aboufama/exo-shoulder/REQUIREMENTS.md

# Requirements

Every requirement is a number with a pass/fail threshold and **one judge that is not the design pipeline and not the agent's
opinion**. `judge/requirements.json` is the machine-readable copy; `judge/scorecard.py` evaluates a design against it.

The user's original statement of the goal, which outranks everything below:

> The whole mechanism must ride less than ~1 cm from the skin across the whole shoulder, over the full range of motion
> (overhead matters most). At most 4 degrees of freedom: 3 joints + a sliding cuff, or 4 joints and no cuff. Everything
> else (mechanism family, joint placement, link shapes, materials, attachment points) is free.

Added by the user on 2026-10-14 (their words):

> "Honestly it would be amazing if it can be handled in only 3 degrees of freedom (less actuators)" ... "3 dof is
> theoretically possible, it just takes a lot of engineering" ... "you could even put upper arm rotation in its own DOF
> farther down from the shoulder and just have to handle 2 at the shoulder joint! If they could fully overlap each
> other, you'd get rid of a lot of collision issues, also you can make it within 14mm if you really need to"

So: **3 DOF is the target** (the cap stays 4); **10 mm stays the target band**, 14 mm is allowed where it is really
needed (e.g. nested links) and is always reported separately (score_design.py `BAND_HI=14`).

And later the same day (their words): "Yes you can download, I mean kinematicly 3dof so nothing is powered we view all
joints as the same. Unless you can find a way to leave one joint unpowered and not require torque to it to use full ROM
that is an exception if you know what I'm saying you can make it as thin as possible, we're using titanium after all".
So: **DOF are counted kinematically - every joint counts, powered or not.** **One exception**: a joint that is left
unpowered and needs no torque (no effort from the wearer) over the full ROM, e.g. a gravity-balanced, self-aligning
passive slider that only lets the rotation centre follow the girdle. **Links as thin as titanium allows** (thickness is
a design variable sized by FEA, not a fixed 5.5 mm). The user approved downloading OpenSim and the Seth 2016 model and
accepted its CC BY-NC-SA 3.0 licence (the experimental bone-pin data in that archive is restricted to verifying the
Seth model and was not used).

**User decisions, 2026-10-15.** Base: "It should ride the scapula, as the next kinematic element is the scapula
handler" - the scapula handler is "a separate part I already designed, you only have to worry about the exactly 3
degrees of freedom found in the shoulder, the minimum possible solution is 3 dof, which is why I'm pushing so hard for
it". Joint count: "I would REALLY like 3 joints, but just push for as low a joint count as possible, this is a huge
reward". Proximity: pass at 14 mm, aim for 10 mm (both reported).

**User decisions, 2026-10-15 (after the sim-to-real register, docs/research/sim_to_real_gaps.md).** Actuation:
remote motors with cables to the joints. Assist: "Don't worry about this at all since they're offset but it would be
very subtle just a bit more than gravity" -> design load = gravity support of the arm plus a margin (~10 N.m peak at
90 deg elevation for an average arm; R9's 25 N.m is retired as the design case). GH-centre error: torque-free passive
self-aligning slides at the cuff, outside the 3-DOF count. Bearings: "use actual tiny needle bearings if possible try
to optimize assuming very high quality bearings" -> rolling (needle / thin-section) bearings at every joint; the
plain-bearing self-locking risk (G6) is designed out, the joint keep-out becomes bearing + cable pulley.

| ID | Requirement | Threshold | Judge | Why this threshold |
|---|---|---|---|---|
| R1 | Proximity: share of the covered skin that is 2-14 mm from the metal, while following | >= 90 % (aim: the same at 2-10 mm, reported as R1-aim) | `pipeline/full-exo/score_design.py` with BAND_HI=14 (exact posed skin, 30 fps) | the 1 cm rule with the user's allowance: pass at 14 mm, aim for 10 (2026-10-15); 2 mm keeps the liner/clearance |
| R2 | No part enters the body, any frame of any clip | <= 0.5 mm | `judge/body_contact.py` (exact signed distance to the posed, closed body mesh) | 0.5 mm = tessellation tolerance; anything more is visible pass-through |
| R3 | The exo follows the arm (frames tracked rather than held at a joint limit) | >= 95 % of frames | `score_design.py` | a held frame means the user's arm is blocked |
| R4 | Overhead works: "Raise overhead" clip score (14 mm band) | >= 80 % | `score_design.py` BAND_HI=14 | the user called earlier designs "unusable" overhead |
| R5 | Degrees of freedom of the shoulder chain (scapula base to arm), counted kinematically (every joint, powered or not) | <= 4; **aim exactly 3** (R5-aim) | `design.json` | user cap and counting rule (2026-10-14); the user's scapula handler is a separate part outside the count, and 3 is the minimum and the goal (2026-10-15) |
| R6 | No interference between parts that move relative to each other | <= 0.15 mm | `judge/part_contact.py` (geometry only) | designed coaxial fits (pin in sleeve, washer on seat) sit inside 0.15 mm |
| R7 | Every custom part is one valid, closed solid | all | `judge/part_validity.py` (OCC BRepCheck on the exported STEP) | a supplier must be able to read and machine it |
| R8 | Custom-part mass | <= 300 g (proposed) | `parts_full.json` (mesh volume x density) | placeholder budget, **confirm with the user** |
| R9 | Strength SF >= 1.5 at the design load (arm gravity support + margin, ~10 N.m; was 25 N.m), worst direction; deflection keeps the 2 mm floor; fatigue bounded | - | **independent FEA (CalculiX)** - today only the in-house hex8 study (`pipeline/conformal/thin_study/REPORT.md`) | 25 N.m = assist torque design load |
| R10 | The base rides the scapula on the user's scapula handler: worst-frame GH-centre misalignment from the base slipping over the bone | <= 4 mm (proposed) | `judge/base_mount.py` (girdle mount: skin-slip model still to build -> NOT RUN; designs with a thorax base keep the three-girdle-law check: rig, published bone-pin chain, **OpenSim Seth 2016**) | 4 mm = half the 2-10 mm band: a misalignment shifts the metal against the skin by up to that much (docs/P0_BASE_MOUNT.md) |
| R11 | Interface pressure under the ISO/TS 15066 body-region limits | - | coupled human-exo contact simulation, then pressure film / FSRs on a prototype | comfort and safety at the cuffs |
| R12 | CAD standard: G2 surfaces, flat seats under every seat, no visible screws or seams | - | zebra / curvature check (`pipeline/full-exo/parts.html`) + user review | the user's own parts set the bar (docs/CAD_STANDARD.md) |
| R13 | Manufacturable | - | supplier DFM review and quote (CNC Ti-6Al-4V / 7075, SLM AlSi10Mg) | only a supplier can say yes |
| R14 | Generalises to motions and bodies never used to design it | - | held-out OpenCap / AMASS clips and SMPL-X bodies (`data/raw/`) | the 8 design clips are synthetic and were optimised against |
| R15 | Works on real bodies | - | printed prototype on the user + one very different body: OpenCap reach vs bare arm, zero contact on skin FSR strips | the final judge |

R1-R8 and R10 are measured today. R9-R15 are the work that turns this from a simulation result into an engineering result.
