aboufama/exo-shoulder/docs/FINDINGS.md

# Findings so far (2026-10-09 .. 2026-10-14)

What has been learned, with numbers, so nobody re-derives it. Earlier history and commits:
github.com/aboufama/exo-arm (archive, private).

## Score history (honest score = `pipeline/full-exo/score_design.py`: follow x share of covered skin 2-10 mm)

| design | honest | notes |
|---|---|---|
| conformal 4R, first CAD (`designs/final`) | 8.1 % | 15-20 mm median gap, overhead follow 39 % |
| band designs, simplified geometry (`designs/band_4c_best`) | 80.5 % | **5 DOF** (4R + cuff), 4.0 mm links, no real stacks / neck / rail - not buildable as modelled |
| GPU search on real geometry, r13 (`gpu_client/band_search_r13.json`) | 37-45 % search, 35-37 % local detail | 5.5 mm links (FEA), v4 joint stack, hugging neck, back/top base |
| r13 4R built as fair CAD, first build | 38.0 % | follows 64.5 %, in-band 58.9 %, zero collisions |
| same, after the quality pass (swept-band links, turned JN hub, conformal saddle cuff) | 29.6 % | follows 64.5 %, in-band 45.9 %; the turned JN hub had lost its contoured skin side |
| same, turned skin side restored (dimple) + neck fixes (2026-10-15) | 32.0 % | follows 64.5 %, in-band 49.6 %, overhead 20.7 %. Same rebuild with the old flat hub: 30.2 % -> the skin side is worth +1.8 pts, the neck changes +0.6 |
| r13 3R + sliding cuff (`cad_r13_n3_s1331_0`), first build with every part valid | 21.2 % | follows 61.0 %, in-band 34.8 %, overhead 20.5 %, 436 g (R8 fail: Ti rail + keel); see "Arm end" |

**Measurement changes are not design regressions.** Stricter skin, natural motions and the in-band metric each moved
numbers on 2026-10-13. Always report a score change with its cause.

The search evaluator (`pipeline/conformal/gpu/band_impl.py`) is optimistic against real CAD: 4 mm slabs, sparse
samples, no stacks/neck early on. The honest scorer on built CAD is the reference.

## The base mount -> R10 (measured 2026-10-14, docs/P0_BASE_MOUNT.md)

The pipeline held the base fixed in the **scapula** frame; physically it bolts to a back plate on the **thorax**. On the
rig's girdle law (GH lift 0.2 mm/deg above 30 deg, scapula rotating about GH), all 1337 frames:
- GH rises up to **25.3 mm** vs the thorax (4 mm at 49 deg elevation, 10 mm at 77 deg); the scapula turns up to 58 deg.
- The reference base on a thorax plate: **enters the body in 197 of 446 frames, up to 44 mm** (Raise overhead) - every
  design so far was shaped against skin that moved with its base.
- **Bound**: any chain whose axes meet at one thorax-fixed point misaligns the GH centre by >= half the GH range =
  **12.7 mm** > the 8 mm band. The fixed-centre family on a back plate cannot meet the 1 cm rule overhead.
- **Offset axes absorb it without a joint**: for fixed axis directions, the GH point a serial chain carries is linear in
  the axis points (`pipeline/girdle/girdle.py`), so the best points are an exact minimax LP. 3-DOF on a thorax plate:
  3R **5.8 mm**, 2R shoulder + humeral-rotation ring **6.8 mm** (vs 25.3). Not yet <= 4 mm (R10 proposed). Sensitive to
  the girdle law: +25 % slope -> 10.8 / 12.5 mm. The residual is flat in elevation: no chain reproduces the rig's
  0-then-linear kink.
- 3R's singular margin: 20 deg on fitting clips, **12.5 deg on held-out** clips. The 2R pointing shoulder: the arm never
  comes within **45 deg** of one axis over the 8 clips -> its singularity has a home (55 deg margin held-out).
- **Humeral-rotation ring**: travel can be 67 deg (87 with held-out Wave; floor 59 deg = twist the clips use at the same
  arm direction). A circular rail on link 2 sees **13.5-25 mm of skin-radius spread** over 120 deg at every station
  80-280 mm down the arm (only the deltoid cap, ~60 mm, is round: 4.7 mm) -> the rail must be arm-fixed and shaped.
- Judge: `judge/base_mount.py` (R10 on every scorecard). Still the rig's law: OpenSim Seth 2016 / OpenCap must replace it.

## Published girdle motion and the red team (2026-10-14)

- **The rig's girdle law is 2-3x too small and 1-D** (docs/research/gh_translation_literature.md): bone-pin clavicle /
  scapula angles through a rigid clavicle chain put GH +35 mm superior at 90 deg scaption (rig 12.7), plus 5-24 mm
  posterior and 10-28 mm medial, plane-dependent; vector error of the rig 16-51 mm. +-7-12 mm (1 SD) is not a function
  of arm orientation. The rig's scapular rotation rates match bone pins, but it pivots the scapula about GH instead of
  the AC joint. Acromion skin plates track the scapula to 5-7 deg below 100-120 deg elevation, up to 25 deg above.
- Under that law (`girdle.lift_literature`): reference chain on a thorax plate 64.9 mm; offset-axis 3-DOF refits
  10.7-19 mm on fitting clips, 22-26 mm held out (`p0_literature.json`).
- **Red team** (pipeline/redteam/REPORT.md): orientation-only chains are >= 12.5 mm off for a -10..+15 mm shrug; the
  reference 4R cannot close in 19 % of the plausible workspace (47-49 % of cross-body poses); P0's 3R gimbal-locks at an
  arm-forward pose near walking (a1 ~ a2); the least-travel ring has a 21 deg closure hole at the T-pose; the elevation
  assist never lands on the rigid saddle - the knit band carries all of it (25 N.m on the saddle = 18 kPa mean).
- **Kinematic optima are not designs**: P0's 3R built as L1 keep-out CAD (`designs/l1_3r_offset`) scores R1 0.1 %,
  R2 25 mm, R6 51 mm - its thorax-fixed J1 hub sits where the raised arm goes. (Fixed contact judges, 2026-10-15: R2
  24.9 mm holds, R6 2.4 mm - the 51 mm was a sign error.)
- **Rig vs the user's parts**: the user's forearm cuff (24 mm) and BOTTOM sit inside the rig's arm in every frame - the
  rig's forearm / elbow is likely too big (P2 scans).

## The human model is wrong in measurable places -> P2

- **Biceps bulge**: the swept upper-arm envelope (max over all frames) sits up to 25-30 mm above the relaxed skin at the
  anterior midline (theta ~ -90 deg about the humerus, s 160-190 mm from GH) at full flexion (132 deg). Triceps ~10 mm.
- **No contact model**: in "wash opposite shoulder" the upper arm passes into the chest; in "walking" (axial -90, arm
  at the side) the posterior-medial arm passes into the torso. Anything hugging the arm inherits these overlaps.
- The upper arm is not round about the humerus: skin radius 36-70 mm depending on direction.

## Cuffs

- **The old upper cuff** (user's forearm cuff scaled x1.24) entered the body in 7 of 8 clips, up to 46 mm, including
  the lateral side. (An earlier check missed it: a name-matching bug skipped it.)
- **A rigid C-cuff wing cannot exist** beyond theta = -20 .. +62 deg about the humerus (0 = lateral, + posterior)
  without touching the trunk or chest in some ADL frame (`fair_cad/out_cuff/trunkmap.npz` method,
  `fair_cad/cuff_trunkmap.py`). Current cuff = a lateral **saddle** under BOTTOM (`fair_cad/cuff_fair.py`): fair
  shrink-wrap inner surface over the swept envelope + 2 mm compressed liner, flat land in BOTTOM's plane, 5 lines + 5
  tangent arcs outline, 6x M4x6 ISO 10642 from inside (same thread engagement as the user's M4x8), 40.6 g AlSi10Mg.
  Zero body contact in every frame. The knit band wraps the rest of the arm.
- The user's **forearm cuff** (not ours, not modified) enters the forearm/biceps 19-27 mm at deep flexion and the torso
  in walking. Flag to the user; do not change their part.

## Links and joints

- **Short link** (r13 4R): J1-J2 hub centres 24.7 mm apart (1.7 mm between the O23 seats), axes 24 deg apart, 5 mm
  height step. No surface treatment fixes it - the search needs a minimum arc (~35 deg at R ~60 mm) so every link has a
  real arm. Same failure the user called "heinous" earlier (two hubs side by side).
  **Guarded since band code `band-2026-10-15t`**: job keys `min_arc` (35 deg; bounds the samplers, rejects in evaluate)
  and `min_arm_mm` (10 mm clear between a link's two hub seats at the fitted hub heights, after the shape fit);
  `make_cad_design.py` refuses either (override `--allow-short-link`, only with the user's OK). The deg rule alone is not
  enough: 35 deg leaves 16.1 / 13.1 / 10.1 / 7.1 / 4.1 mm between O23 seats (r 11.5) with hubs 65 / 60 / 55 / 50 / 45 mm
  from GH, and 5.1 mm at 65 mm with r 17 seats. Conversely r13's link 3 (29.6 deg) has 16.9 mm at its fitted 74 / 80 mm
  hub heights: the deg rule rejects it, the mm rule would not. The evaluator's geometry puts r13's link 1 at 2.1 mm.
- **Construction that reads as designed** (members.py `FIELD_MODE=swept`, default): each arm a swept constant-section
  band (straight generators across its 14 mm width, one fair height profile along it, clamped in value and slope to the
  hub planes), thickness easing hub stack -> 5.5 mm over 12 mm, G2 blend into exact hub planes over 4 mm. The earlier
  2-D "fair field" and the original local-lift fields produced folds and lumps.
- **Stacked joints**: the lower link's top must stay under its seat plane + 35 deg near the hub (it thickens toward the
  skin instead), otherwise the upper link leaps over it in a cliff. Joints whose hub plane sits below the skin floor get
  raised (ramp check) - J1 needed 3.7 mm once; cap lower hub plates at 6.5 mm or they become blocks.
- **Edge round 0.5 mm on links**: with 1.2 mm the flat seat ended at r 10.3 and the O22 cap skirt (r 9.3-11) and its
  M1.6 screws (r 10.15) overhung the round - a fit error and an invalid sliver face.
- **v4 joint** (`fair_cad/joint_v4.py`, docs/HARDWARE.md): O23 hub, 10.47 mm above the skin face; magnet + sensor PCB
  placeholders under a O22 G2 dome cap.

## Arm end (BOTTOM + neck + J4 hub, one 7075 part)

- **Turned hub + swept neck** (`armend_fair.build_hub_neck_v2`): revolve with exact seat; neck = constant 14 x 6.5
  section along the skin-hugging path, starting 6 mm inside the hub.
- **Turned skin side** (`hub_need` / `fit_underside`): per ring radius the axial height the dense envelope allows (max
  over the ring and all followed frames, skin + 2 mm + 0.5), then the closest sketch above it - centre flat + cone
  (+ the old face F as an outer annulus = "dimple"), short G2 corner blends, revolved. r13 n4: centre 3.1 mm under F to
  r 2.5, 25 deg cone back to F by r ~10. Radial skin gap under the hub: min 3.15 -> 2.71 mm, worst-frame median 7.14 ->
  4.78, all-frames median 13.33 -> 11.46; exact body clearance of the hub region (451 frames) 2.68 -> 2.60 mm.
- **Neck end**: morphing the 14 mm neck into BOTTOM's 30 mm bar section over the last few mm folded the loft (the
  lateral face self-intersects; OCC `isValid` still says True, every later boolean silently fails). Now the neck keeps
  14 x 5.5 and runs 6 mm into BOTTOM past the cut -> plain transversal fuse (`NECK_END=bar` = old). Inside the hub it
  starts 5.9 thick (0.3 inside both hub faces) so nothing is coincident or tangent; a flat face 0-0.4 mm under F is
  snapped to F (a neck underside grazing the rim blend broke the recess cut). Check lofts with
  `armend_fair.self_x` (BOPAlgo_ArgumentAnalyzer), not `isValid`.
- **3R + sliding cuff** (`cad_r13_n3_s1331_0`): every part one valid solid now (R7). What was broken:
  (1) `sheet.sheet_solid` sewed the 5 faces at 5 um and took the FIRST shell: on steep members the edge rounds drift
  from the exact trimmed outline, sewing leaves several shells -> an open 3-4 face "solid" with a meaningless volume
  (reproduced on the official maps: link 1, 4 faces, invalid). Now: retry 0.02-0.1 mm, keep the one closed shell.
  (2) the evaluator's ribbon floor for link 2 started 29 mm above J2's plane at J2's rim (JN plane 119 mm vs J2 61 mm
  from GH, ramp-limited from JN only) -> an 85 deg wall, J2 raised 12 mm by the ramp loop, link 2's skin side 8 mm inside
  the envelope. Now the floor is capped at RAMP_DEG out of every hub plane (`Member.ramp_cap`): J2 raise 2.6 mm, link 2
  -1.4 mm, link 1's J2 hub 0.8 mm over its need (was 9.2). (3) rail + neck were ONE loft whose dovetail-with-keel
  sections morphed into the neck: self-intersecting -> the BOTTOM merge returned 0 cm3 and assemble crashed. Now
  (`build_dovetail_rail_neck`): exact revolve head, straight-quad keel loft to the skin envelope, separate neck (smoothing
  spline path, approach run down the bar's axis). (4) saddle: channel tool had a sign error (a 13 mm rectangular slot,
  no dovetail) and the 18 mm plate was narrower than the v4 washer recess (r 9.15-9.3) -> recess broke out of its
  sides; now the dovetail + liner offset, plate 2 x 12.3. (5) the top-mounted base: cap-screw drills ended exactly on the
  seat face (invalid solid) and the 3 M2 back-plate holes sat 0.075 mm from a cap-screw hole / 0.55 mm from the disc
  edge; now drills cross the face, M2 at r 12 between the cap screws on a O28 disc.
- Still wrong on the 3R build: the neck runs back beside the rail toward the bar and grazes the saddle's lip in the
  last ~2.5 deg of travel (0.44 mm at the clips' max 45.0 deg, 0.55 at the 45.6 deg limit; true ray-parity check); the
  rail part enters the body by 1.0 mm (ray-parity verified, 'Wave' 60); the JN plate sits ~35 mm above the skin
  (zj4 112) so the skin-following keel is 4.5-40 mm deep and the rail part is 63 cm3 of Ti (R8 436 g).
- **Travel of an arc slide / open ring** (for a 2R + humeral-rotation ring): an ARM-fixed ring at this rail's height (64 mm
  down the humerus) is body-free (> 2 mm, all 451 clip frames, exact distance) only over 130 deg at r 92 mm about the
  humerus axis and 124 deg at r 80; at r 70 (about skin + 1 cm) it hits the body even at its centre. Travel + the
  saddle's length (+-8 deg) + the neck must fit inside that window, so 120-160 deg of travel cannot be an arm-fixed rail
  here; the long arc has to ride on the shoulder side (it then does not turn with the humerus) with a short arm-fixed
  cuff, and its constant radius stands off a non-round arm (36-70 mm skin radius). Other limits seen in this build:
  one-end neck = a long cantilever arc; the 26 mm saddle and the stop slot set the end stops; the neck must leave
  beyond the saddle's reach (here the body window ends 0.3 deg past the saddle's travel).

## Structure (in-house FEA, `pipeline/conformal/thin_study/REPORT.md`)

25 N.m worst direction: link bodies need ~5.5 mm (SF 1.5); seat zones carry 0.3-0.6x body stress; a cuff rail needs
>= 10 mm in Ti; the 7075 neck at 14 x 6.5 has SF ~2. **Not independently verified (R9).**

## Infrastructure

- RunPod Flash endpoints: band evaluator `exo-band10` (5ogdx1ex9wyh02), Blender Cycles render `exo-blender-cycles`
  (dj3qfmtwrwy2pr). Warm workers serve old code after a deploy -> new endpoint name per code change, check
  CODE_VERSION. Queued jobs may need `workersMin` PATCHed > 0 to start; reset to 0 after. Account quota 10 workers.
- The dense per-frame skin maps (`.cache/maps_s1.pt`, 857 MB) are not in git: `tools/build_maps.py`.
- **The contact judges over-reported - fixed 2026-10-15 (judge/sdist.py, judge/test_sdist.py).** The old sign came from
  the face normal of the nearest of 10 triangle centroids; on long glb facets and the coarse body mesh (median edge
  8 mm, max 87 mm) the true closest triangle was often not among them (e.g. "link 2 IN J2 cap" 4.78 mm where ray parity
  in 3 directions and the winding number find 0 points inside), and the posed body self-intersects (winding up to 3)
  where no normal-based sign exists. Now: exact closest point (covering samples + one ball query) and the integer
  winding number (scanline grid + segment crossings). Test vs brute force: wrong inside 0 % on cube, sphere, a real
  part and the posed body (old: 0 / 0 / 2.6 / 2.8 %), |d| error 0. **Measurement change** on the reference
  (cad_r13_n4_s1343_1): R6 37.64 -> 0.80 mm (15 pairs > 0.15 mm), R2 24.43 -> 24.62 mm (the user's forearm cuff vs the
  rig's forearm: a size mismatch, not exo metal).
  Follow-up the same day: vertices are welded first (glb = one tessellation per B-rep face; the pseudo-normal sign of
  `signed_distance` needs shared edges). Every part closes after welding except the 3R BOTTOM + rail (11 boundary + 4
  non-manifold edges), which the first winding version skipped as a container (38 pairs, including the cuff's liners
  on the rail). It is now tested by the majority of x / y / z ray sweeps, with the generalized winding number wherever
  they disagree; test_sdist adds a raw (unwelded) part, a sphere with 4 holes and the open BOTTOM: 0 % wrong.

  | measurement change (no design changed: score.json, part_validity.json re-ran identical) | R2 before -> after | R6 before -> after |
  |---|---|---|
  | `cad_r13_n4_s1343_1` (4R), `judge_all.sh fast` (R2 step 6, R6 step 12) | 24.43 -> **24.62 mm** | 37.64 -> **0.80 mm** |
  | same, full run (R2 step 2, R6 step 4; the committed outputs) | 24.62 mm | 0.80 mm |
  | `cad_r13_n3_s1331_0` (3R + sliding cuff), `judge_all.sh fast` | 21.88 -> **21.94 mm** | 90.07 -> **0.55 mm** |
  | same, full run (the committed outputs) | 21.94 mm | 0.55 mm |

  Outside check, `judge/xcheck_contact.py` (no code shared with sdist: raw unwelded glb, signed crossings on 3 random
  rays, brute-force closest point; `<design>/judge/xcheck_contact.json`): every old top R6 entry (9 per design, 37.64
  and 90.07 included) and the old 4R R2 top entry (J4 washer A, 24.43 mm) have 0 vertices inside (one coaxial sleeve in
  its washer touches at 0.00 mm); the new top R2 / R6 entries (4R 15, 3R 11) agree with the judge to 0.00 mm.
  What the corrected numbers say:
  - R2 is real body entry now. Worst: the user's FOREARM CUFF in the rig's forearm (24.6 / 21.9 mm; see "Rig vs the
    user's parts", P2) and the forearm screw / MIDDLE (8.4 / 5.8 mm). BOTTOM: 4R 4.96 mm (fast 4.71, was 13.11), all in
    the user's bar (s < 265), neck + JN hub 0; 3R 5.98 mm in the bar (fast 5.89), its neck + rail 1.16 mm ('Wave' 62;
    fast 1.03 at 'Wave' 60, = the ray-parity figure).
  - R6, 4R: only contacts at the joints remain - J4 ring nut in the J4 cap 0.80 mm, link 1 in the base 0.62, J4 cap
    screw in the ring nut 0.50, washer B in the J4 cap 0.42; the M1.6 cap screw sits 0.17 mm into washer B at J1-J3 of
    both designs (a stack overlap just over tol). 3R: the cuff's flank liner in the BOTTOM + rail 0.55 mm ('Wash
    opposite shoulder' 192, a held frame; 83 of 339 frames) - likely the end-of-travel graze of "Still wrong on the 3R
    build" above; invisible while the judge skipped the open BOTTOM (that version: 3R R6 0.17 mm).
  - The other designs judged with the old rule, re-judged the same night (fast: R2 step 6, R6 step 12; the outside
    check agrees with every top entry to 0.00 mm):

    | design | R2 before -> after | R6 before -> after |
    |---|---|---|
    | `band_r14_4r_s1354_0` | 24.15 -> 24.87 mm (the user's forearm cuff) | 14.80 -> 1.99 mm (member l2 / l3; after re-orienting, below) |
    | `band_r14_3r_s1351_1` (R6 step 4) | (24.87 mm, upstream re-judge) | 1.09 -> 1.09 mm (+ base in l1 1.00 mm, missed before) |
    | `l1_3r_offset` | 24.98 -> 24.94 mm (real: keep-out slabs in the arm) | 50.84 -> 2.40 mm |
    | `l1_r14_3r_s1351_1` | 24.89 -> **0.00 mm: passes** | 11.09 -> 2.39 mm |

    `l1_r14_3r` R2: its three old entries (24.89 / 24.71 / 17.28 mm) have 0 vertices inside by brute force, and the
    reverse test (skin vertices inside its coarse keep-out meshes, every 6th frame) is 0 too, so nothing hides between
    the part's vertices. Only README's historical first run (R2 24.4, R6 18.5 mm) keeps old-rule numbers.
  - **Face orientation.** The band builds' proxies (`D4 member ... (proxy)`, `BOTTOM JN hub block`, the carriage) come
    watertight but with mixed face orientation, some wholly inside out (negative volume) - in every `band_*` design.
    A winding number (and any normal-based sign) is meaningless there: an inside-out proxy never contains anything, a
    mixed one is wrong in patches. So `band_r14_4r` read R6 0.00 mm (fast) / 2.0 mm (upstream full run) with the
    proxies as they came. `Mesh` now re-orients (`sdist.orient`: consistent across every two-face edge, then each closed
    piece outward); the outside check takes R6's inside from ray parity, which does not depend on orientation. Only R6
    of the `band_*` builds moves: their R2 / R10 container is the body (consistent), and every CAD / L1 part re-orients
    0 faces. Tests: 30 % of a real part's faces flipped / the part inside out -> 0 % wrong. Also: Mesh welds only a
    mesh with boundary edges - the body is closed as given, and welding merged 16 coincident (quantised) vertex pairs
    into non-manifold edges; it had sent R2 down the open-mesh path (still exact, slower). R2 re-ran identical.
  - `signed_distance` (red team, P0) now takes its sign from the winding number too: on the posed body the
    pseudo-normal sign was 1.9 % wrong near the surface (self-overlap), now 0 % (`judge/test_sdist.py`); ~2-4 s more
    per whole-body call. `unsigned_distance` for |d| only (rt_ring's open trunk / forearm patches). Results that
    `rt_pressure`, `rt_bottom`, `rt_ring` and `p0_base_mount` computed with the old rule are NOT re-run yet.
