aboufama/exo-shoulder/docs/P0_BASE_MOUNT.md

# P0: base-mount physics (R10)

Question: the pipeline holds the exo's base fixed to the **scapula**; physically it bolts to a back plate on the
**thorax**. How far apart are those, what does it do to the reference design, and how is it resolved within the DOF cap
(target 3 DOF, user 2026-10-14)?

Instrument: the body rig's own girdle model (`pipeline/avg/body_pose.py`: `segs()` lifts the GH centre by
0.2 mm/deg x S above 30 deg elevation, `scap()` turns the scapula about the GH centre), exact signed distance to the
posed skin (`judge/sdist.py`), every frame of the 8 clips (1337 frames, the person's wanted poses).
Code: `pipeline/girdle/p0_base_mount.py` (analysis), `pipeline/girdle/girdle.py` (chain maths), results
`pipeline/girdle/p0_results.json`. Judge that keeps it measured: `judge/base_mount.py` (R10, every scorecard).
**Not yet cross-checked with OpenSim Seth 2016** (download needs the user's OK) - every number below inherits the rig's
girdle law, which is a hand-made model (purely superior, zero below 30 deg).

## 1. The human: GH centre and scapula vs the thorax

| clip | max elevation | GH rise vs thorax | scapula rotation |
|---|---|---|---|
| Raise overhead | 150 deg | 25.3 mm | 57.8 deg |
| Comb hair | 143 | 23.9 | 54.9 |
| Reach a high shelf | 132 | 21.5 | 50.1 |
| Wave (held out) | 95 | 13.7 | 34.1 |
| Drink from a cup | 69 | 8.2 | 22.8 |
| Wash opposite shoulder | 60 | 6.2 | 18.9 |
| Reach back pocket | 40 | 2.1 | 10.5 |
| Walking arm swing (held out) | 24 | 0.0 | 3.8 |

The GH centre passes 4 mm at 49 deg elevation and 10 mm at 77 deg.

## 2. The base part on a thorax plate

Between the pipeline's model (base turns with the scapula) and a thorax-fixed base, the reference base part's vertices
move up to **57.6 mm** (p95 55.2). Bolted to the thorax, the base part **enters the body in 197 of 446 checked frames,
up to 44.0 mm deep** (worst: Raise overhead, pose plane 30 / elev 150 / axial -60): the rising shoulder runs into a base
that no longer rises with it. Every design so far was shaped against skin that moved with its base.

## 3. The reference chain (4R, every axis through the GH centre) on a thorax base

- GH misalignment = the GH rise itself: worst **25.3 mm**, p95 23.8 mm; > 4 mm in 48 % of frames, > 10 mm in 33 %.
- The 4R closure still exists in every frame with the base thorax-fixed (kinematics only): the spare joint can absorb
  the scapula's 58 deg of rotation. The rotation is not the problem; the translation is.
- **Bound (new):** a chain whose axes all meet at one point fixed to the thorax misaligns the GH centre by at least half
  the range of GH positions - **12.7 mm** on the rig with the best possible centre. That exceeds the whole 8 mm width of
  the 2-10 mm band, so no link shaping can keep the metal in the band over the full range of motion: the
  fixed-centre-on-a-back-plate family is ruled out by the data, not by taste. (A misalignment e shifts the metal
  against the skin by up to e; staying in a band of width 8 mm needs e <= 4 mm - the proposed R10 threshold.)

## 4. Resolutions within the cap

| architecture (base on a thorax back plate) | DOF | worst GH misalignment mm | p95 | held-out worst | notes |
|---|---|---|---|---|---|
| spherical chain (all axes through GH), centre at GH rest = the reference as built | 4 | **25.34** | 23.78 | = | fails R10 by 6x |
| spherical chain, best fixed centre | any | **12.67** | 12.67 | = | the bound of section 3: > the 8 mm band |
| spherical chain + passive vertical base slide | N+1 | **0.0** | 0.0 | = | 0 only because the rig's lift is purely vertical; a passive joint counts as a DOF |
| **3R, offset axes** (axes need not meet at GH) | **3** | **5.82** | 5.63 | 5.82 | axis offsets [5.2, 7.6, 5.4] mm; singular margin 20.0 deg fit / **12.5 deg held-out** |
| **2R shoulder (offset axes) + humeral-rotation ring** (user's idea) | **3** | **6.79** | 6.46 | 6.79 | axis offsets [10.3, 5.8, 0.0] mm; singular margin 28.1 / 55.4 deg; ring travel 163.8 deg at this fit |
| scapula-fixed base (the pipeline's model) | - | **0.0** | 0.0 | = | not buildable: no back plate rides the scapula |

Residual by elevation is flat (3R: {'0-30': 4.5, '30-60': 4.68, '60-90': 5.63, '90-120': 5.82, '120-181': 4.68}; ring: {'0-30': 5.19, '30-60': 6.69, '60-90': 6.79, '90-120': 5.84, '120-181': 6.58}): a chain's translation is a smooth
function of its joint angles and cannot reproduce the rig's kink (0 mm up to 30 deg, then 0.2 mm/deg), so the minimax
spreads the error. Joint travel (3R): {'J1': {'min': 2.3, 'max': 163.0, 'span': 160.7}, 'J2': {'min': -20.6, 'max': 90.2, 'span': 110.8}, 'J3': {'min': -173.4, 'max': 17.0, 'span': 190.5}}.

**The ring, measured.** (a) *Travel*: the misalignment-optimal ring fit needs 163.8 deg of ring travel, but the
2R geometry can be chosen for travel instead: **66.7 deg** on the fitting clips, 86.5 deg with the held-out Wave
(`ring_travel.py`); the floor is **58.8 deg** - the humeral twist the clips use at nearly the same arm direction
(Wave, pose [16, 83, -56]). Misalignment and ring travel pull the 2R geometry different ways: a P3 trade-off.
(b) *Roundness* (`ring_roundness.py`): a circular rail centred on the humerus axis sees the arm's skin radius vary by
**13.5-24.9 mm over 120 deg** at every station 80-280 mm below GH (elbow 0-140 deg) - more than the whole band - and
only the deltoid cap (~60 mm) is round (4.7 mm over 120 deg, 9.9 over 160). So the rail must be **arm-fixed with a skin-
shaped underside** (carriage on link 2), and an arm-fixed rigid arc must fit the trunk-free window (-20..+62 deg about
the humerus, FINDINGS): ~67 deg travel + ~25 deg carriage ~ 92 deg vs an 82 deg window - tight, not impossible.

## 5. Where the arm never points

Over all 1337 frames the humerus never comes within **45.4 deg** (either sense) of the axis
(-0.525, -0.253, 0.812) in the thorax frame (x anterior, y up, z right): posterior-inferior-lateral <-> anterior-
superior-medial. That is the place for the singular configuration of a 2R pointing shoulder (J1 along it, a1 = a2 = 90):
the user's "2 at the shoulder + humeral rotation lower down" is kinematically sound for these 8 tasks, with a 45 deg
margin before the arm reaches the singular direction.

## 6. How fragile the 3-DOF fits are to the girdle law (synthetic laws, NOT data)

| fitted design | rhythm law (synthetic) | worst mm | p95 |
|---|---|---|---|
| 2R+ring | slope x0.75 | 7.6 | 7.11 |
| 2R+ring | slope x1.25 | 12.48 | 11.32 |
| 2R+ring | onset 20 deg | 8.48 | 7.68 |
| 2R+ring | onset 40 deg | 7.63 | 7.03 |
| 2R+ring | +8 mm anterior in flexion | 10.66 | 9.03 |
| 3R offset | slope x0.75 | 5.77 | 5.55 |
| 3R offset | slope x1.25 | 10.83 | 8.79 |
| 3R offset | onset 20 deg | 7.12 | 7.07 |
| 3R offset | onset 40 deg | 6.56 | 5.86 |
| 3R offset | +8 mm anterior in flexion | 11.03 | 9.36 |

A design fitted to one girdle law loses 1-6 mm when the law changes by plausible amounts. This is why the R10 judge must
move from the rig law to measured trajectories (OpenSim Seth 2016; the user's OpenCap shoulder markers) before any
3-DOF design is committed to CAD at L2, and why P3 fits against several laws at once (minimax).

## 7. Against published girdle motion (the literature law, not the rig)

`docs/research/gh_translation_literature.md`: bone-pin clavicle / scapula angles (Ludewig 2009) through a rigid
clavicle chain put the GH centre 35 mm up at 90 deg scaption (rig 12.7), plus 5-24 mm posterior and 10-28 mm medial,
plane-dependent; +-7-12 mm (1 SD) of it is not a function of arm orientation. `girdle.lift_literature` +
`p0_literature.py` (`p0_literature.json`):

| design on a thorax plate | fitted to | worst, rig law (fit / held-out) | worst, literature law (fit / held-out) |
|---|---|---|---|
| spherical chain (the reference) | - | 25.3 | **64.9** |
| P0 3R / 2R + ring (rig-fitted) | rig | 5.8 / 6.8 | **47.0 / 47.1** |
| 3R, offset axes | literature | 39.6 / 23.7 | 10.7 / **25.9** |
| 2R + ring, offset axes | literature | 32.8 / 26.0 | 19.2 / 21.7 |
| 3R, offset axes | both laws | 23.3 / 15.9 | 22.9 / 31.9 |
| 2R + ring, offset axes | both laws | 23.0 / 19.4 | 22.8 / 26.4 |

plus the non-repeatable +-7-12 mm, which no chain without a girdle joint can follow. **Counter-example from the data:
no rigid chain on a thorax back plate with at most 4 DOF and no girdle joint keeps the GH misalignment under the band
for published girdle motion** (best 10.7 mm on the fitting clips, 22-26 mm held out). Unless the user's own girdle
moves far less than published (ruler test / OpenCap, data/raw/README.md items 0 and 2), the thorax-plate premise of R10
and the 4-DOF cap cannot both hold with the 1 cm rule.

## 8. The user's exception: one torque-free passive joint (self-aligning slider)

User, 2026-10-14: DOF are counted kinematically, but one joint that is unpowered and needs no torque over the full ROM
is allowed. That is the self-aligning principle of Stienen et al. 2009 (decouple the exoskeleton's rotations from its
translations): a passive slider between the thorax plate and the shoulder chain transmits every moment, so the assist
reaches the plate as a pure couple and nothing pushes along the slide; the rotation centre goes wherever the girdle takes
it. Residual misalignment = the part perpendicular to the slide (still linear in the axis points: exact minimax LP).
`p0_selfalign.py` -> `p0_selfalign.json`:

| design | slider direction e (thorax) | worst, rig law: fit / held-out mm | worst, literature: fit / held-out mm | slider travel mm | singular margin fit / held-out deg |
|---|---|---|---|---|---|
| spherical + slider, fitted to rig | [0.0, 1.0, -0.0] | 0.0 / 0.0 | 32.6 / 26.21 | 55.4 | - |
| spherical + slider, fitted to literature | [-0.264, 0.926, -0.272] | 13.15 / 8.75 | 7.85 / 6.0 | 63.4 | - |
| spherical + slider, fitted to rig+literature | [0.481, -0.726, 0.491] | 9.73 / 7.7 | 9.73 / 7.31 | 62.3 | - |
| 2R+ring offset axes + slider, fitted to literature | [-0.316, 0.826, -0.468] | 12.48 / 3.4 | 2.81 / 9.11 | 52.0 | [24.5, 33.5] |
| 2R+ring offset axes + slider, fitted to rig+literature | [-0.384, 0.76, -0.524] | 3.99 / 4.85 | 3.99 / 7.79 | 56.0 | [22.4, 38.7] |
| 3R offset axes + slider, fitted to literature | [-0.439, 0.723, -0.533] | 7.94 / 6.27 | 2.34 / 7.77 | 50.0 | [34.6, 43.1] |
| 3R offset axes + slider, fitted to rig+literature | [-0.412, 0.769, -0.49] | 4.66 / 5.1 | 4.66 / 7.72 | 57.0 | [25.8, 24.0] |

- **2R shoulder + humeral-rotation ring + offset axes + one passive slider, fitted to both laws: 3.99 mm worst on the
  fitting clips under both laws** (the proposed R10 is 4 mm), 4.9 / 7.8 mm on the held-out clips (overfitting the 6
  clips: fit on the whole workspace next). Slider travel ~56 mm.
- The slider direction comes out the same in every fit: **up, medial and slightly posterior** (~(-0.4, 0.76, -0.5)) -
  the line along which clavicle elevation carries the shoulder. The search reinvented a passive clavicle.
- "No torque" in practice: low-friction slide (the ring/shell hardware note's caged-ball or iglidur options) and a
  ~1-2 N gravity-balance spring for the ~150 g chain; it then needs no effort from the wearer.
- A pure-vertical 15 mm shrug still leaves 11-14 mm (it is off the slide axis); a real shrug moves along clavicle
  elevation, close to the slide - to be checked against the OpenSim Seth model and the user's OpenCap.

### 8b. Against all three girdle laws (rig, literature chain, OpenSim Seth model) - `p0_selfalign3.json`

The OpenSim Seth 2016 model driven by published angles (docs/research/opensim_seth2016_gh.md) lands between the rig and
the literature chain (superior GH at 90 deg: rig 12.7, Seth 20-29, chain 24-38 mm; much less posterior / medial than the
chain), and +-1 SD of the published angles moves GH by 19-22 mm. Fitting one design to all three laws at once:

| design (thorax plate + one torque-free slider) | worst over the 3 laws, fitting clips | held-out: rig / literature | slider travel | singular margin fit / held-out |
|---|---|---|---|---|
| spherical chain | 11.1 mm | 6.6 / 10.6 | 63 mm | - |
| **2R + ring, offset axes** | **6.8 mm** | 4.7 / 10.1 | 52 mm | 23.5 / 17.0 deg |
| 3R, offset axes | 6.3 mm | 5.8 / 12.2 | 58 mm | 20.0 / 25.8 deg |

Fitted to ONE law the same families reach 2.3-4.0 mm (section 8). **The remaining ~6.5 mm is the disagreement between
the published girdle models (5-16 mm in AP / ML), not a limit of the mechanism**: the next number has to come from the
user's own girdle (ruler test, OpenCap - data/raw/README.md items 0 and 2), and the design is then fitted to that person
(with the population spread handled by the slider + liner compliance, and checked on SMPL-X bodies later).

### 8c. Over the whole plausible workspace (`p0_selfalign_ws.py` -> `p0_selfalign_ws.json`)

Fitting the self-aligning 2R + ring + slider over the red team's plausible everyday workspace (49,543 poses: plane
-90..150, elevation 0..170, humeral rotation +-90 about the twist-free neutral; fitted on a 10 deg grid, rig + literature
laws): **worst 8.7 / 9.0 mm** over the whole 5 deg workspace (p95 7.2), clips 5.7 / 7.9 (fitting) and **5.0 / 3.5
(held-out - no longer overfitted)**; closes everywhere; slider travel 74 mm. Two limits that are geometry, not tuning:
- Over the workspace the arm comes within **8.6 deg** of every axis (best: down-medial into the trunk): a 2R pointing
  shoulder cannot hide its singularity from everyday ROM (min margin 6.5 deg, 1st percentile 13 deg).
- **The ring must turn a full circle over the workspace** (covering arc 357-360 deg even with humeral rotation limited
  to +-30 deg; 115 deg over the 8 clips): link 2's roll about the arm winds 360 deg around the pointing singularity,
  and everyday arm directions encircle it. Physiological humeral rotation at the side alone is ~150-180 deg (why
  CADEN-7 uses a 180 deg guide). An open ring that must also clear the trunk (82 deg arm-fixed window) cannot cover that:
  **the 2R + ring follows the 8 everyday clips, not full humeral-rotation ROM.**

### 8d. Can any 3-DOF rotation chain keep its singularity out of the full everyday ROM? (`singular_free.py`)

A 3R chain (a1 = a2 = 90) locks when its arm-fixed axis w lines up with the base axis b (R_arm w || +-b). Searching all
(b, w) pairs over the plausible workspace (49,543 poses, humeral rotation +-90 deg at every arm direction): the best
3R stays only **8.7 deg** from singular (b = [-0.288, 0.537, 0.793], w along the humerus); w = the humerus axis (the
2R + ring) gives 8.2 deg. **Counter-example from the data: no 3-DOF rotation chain is singularity-free
with a useful margin over that full ROM.** 3 DOF can follow everyday motion with its singularity parked at a rarely used
extreme (to be weighed with real ADL distributions: AMASS / OpenCap); a margin over the full ROM needs the 4th joint the
cap allows (4R + the slider exception). The plausible-ROM box is generous (+-90 deg rotation everywhere); real joint
limits shrink it, which is exactly what the user's OpenCap / AMASS data must decide.

## Decision

1. **A thorax back plate with a chain whose axes all meet at the GH centre is ruled out** (section 3: >= 12.7 mm
   misalignment with any fixed centre, wider than the band). Every design so far, the reference included, is in that
   family; its overhead numbers were measured against a base that moved with the scapula.
2. **Primary family: 3 DOF with offset axes on a thorax plate** - the user's target. On the rig law it brings the worst
   misalignment from 25.3 mm to **5.8 mm (3R)** / **6.8 mm (2R + humeral-rotation ring)**, with no extra joint and no
   actuator. That passes a 2-14 mm band (the user's allowance, e <= 6 mm) for 3R, not yet the proposed R10 (4 mm, the
   2-10 band). Closing the last ~2 mm, in order of preference: (a) P3 searches directions for misalignment AND skin
   hug together, minimax over girdle laws; (b) a compliant arm interface (liner + strap) specified to take +-2-3 mm,
   which turns R10 into "residual <= liner travel"; (c) only if the user allows a *passive* joint: a girdle slide (+1
   passive DOF, 0 mm on the rig).
3. **The 2R + ring is kinematically sound** (45 deg from the singular direction over all 8 clips, 55 deg margin on
   held-out clips), but its rail must be arm-fixed and shaped, the travel minimised (~67-87 deg), and it lives near the
   deltoid cap or in the lateral-posterior window - P3 objectives, not afterthoughts. The 3R has the smaller misalignment
   but its singular margin collapses on held-out motion (12.5 deg): the red team is searching the full ROM for its jam.
4. **R10 is now a judged number** on every scorecard (`judge/base_mount.py`, threshold 4 mm proposed); the reference
   design fails it at 25.3 mm, and its base part enters the body by 44 mm on a thorax plate.
5. Before L2 CAD of any 3-DOF design: the girdle law from OpenSim Seth 2016 and the user's OpenCap (data/raw/README.md
   items 1-2).
6. **Section 7 overturns item 2 if the literature holds** (it is the better evidence: bone pins vs a hand-made law).
   Three ways forward, for the user to choose (they change R10 or R5):
   - **A. 3 DOF on a girdle-riding base** (a strapped saddle over the acromion / clavicle / scapular spine; no rigid
     back plate, or one joined through a soft tether): the base follows the girdle, which is what every design so far
     assumed (scapula frame). Error = skin slip over the acromion: ~5-7 deg below 100-120 deg elevation, up to 25 deg
     above (literature) - small below shoulder height, large overhead. Reaction loads go through the girdle skin (R11).
     Keeps 3 DOF; R10 is rewritten as "base tracks the girdle within X mm".
   - **B. Thorax plate + a passive girdle mechanism** (elevation + protraction, unactuated) + 3 actuated shoulder DOF:
     3 actuators, 5 DOF in total - over the cap of 4.
   - **C. Thorax plate + 3 rigid offset-axis DOF** (this P0's design): only if the user's measured girdle motion is
     close to the rig law (residual 5.8-6.8 mm), i.e. the ruler test shows ~13 mm, not ~35 mm, of acromion rise at 90 deg.
7. **After the user's counting rule (section 8), the recommended architecture is B': thorax plate on stable skin
   (>= ~175 mm medial of GH: spine / neck base) + one gravity-balanced, torque-free passive slider along the clavicle
   line + the user's 3-DOF shoulder (2R pointing with offset axes + humeral-rotation ring on the upper arm).** It keeps
   3 kinematic DOF + the one allowed exception, and is the only family so far that holds ~4 mm under both girdle laws.
   Next: re-fit over the whole workspace and the OpenSim Seth-model law, then P3 with skin hug (L1 builds).
8. **Decided by the user (2026-10-15): option A with the user's own scapula handler.** "It should ride the scapula,
   as the next kinematic element is the scapula handler" - a separate part the user already designed, outside the DOF
   count; "you only have to worry about the exactly 3 degrees of freedom found in the shoulder". So the shoulder chain
   is searched and judged in the scapula frame (what band_impl.py already does), its target is exactly 3 DOF, and R10
   becomes the base's slip over the bone: grip on the acromion + scapular spine (least skin slip), the handler carries
   the reaction loads to the trunk and must be torque-free. The slip judge is the next R10 work; until then
   `judge/base_mount.py` reports NOT RUN for girdle mounts.
