aboufama/exo-shoulder/pipeline/full-exo/report.html

# EXO shoulder: winning designs in real CAD

Searched on the real part geometry (FEA-sized 5.5 mm link bodies, the v4 joint stack, skin-hugging neck merged into BOTTOM, base anchored to the back plate), built as G2 sheet bodies and checked for collisions in every frame. Scores are the honest skin-band measure over the eight daily-living motions. Joint v4 in 3D · Film preview

## Joint v4 (every joint)

Lower plate 3.0 mm · washer A recessed (0.15 proud) · upper hub 4.05 mm · washer B · ring nut on an M8×0.5 stub (sets 0.02 mm float) · magnet Ø4×2 N52 under the sensor IC (0.40 mm gap) · Ø22 G2 dome cap · 10.47 mm above the skin face on a Ø23 hub. Same bearing internals as v3 (igus iglidur G thrust washers 10×18×0.5, GSM-1012-04 sleeve, integral Ø10 h9 Ti pin), FEA-sized at 25 N·m worst direction.

## smoke test (old 4R)

Open in 3D viewer

12.1%honest score

32%frames followed

38%covered skin 2–10 mm

226 gcustom parts

4DOF

### Per motion

Raise overhead7%

Drink from a cup12%

Comb hair17%

Reach a high shelf0%

Wash opposite shoulder12%

Reach back pocket22%

Wave8%

Walking arm swing23%

### Kinematics

J1 axis az 73° / el 50° (base on the top/back of the shoulder) · arcs 29°, 61°, 27° · J4 axis 97° / -14° on the arm

### Parts

part | material | g
BOTTOM + neck + JN hub (one 5-axis part, 7075-T6 bead blasted) | 7075-T6 | 100.3
D4-01 scapula base (Ti-6Al-4V) | Ti-6Al-4V | 23.3
D4-02 link 1 (Ti-6Al-4V) | Ti-6Al-4V | 18.9
D4-03 link 2 (Ti-6Al-4V) | Ti-6Al-4V | 37.6
D4-04 link 3 (Ti-6Al-4V) | Ti-6Al-4V | 19.4
cap Ø22 G2 dome × 4 | | 18.4
ring nut M8x0.5 18x1 × 4 | | 3.6
position PCB Ø16 × 4 | | 2.1
sleeve × 4 | | 0.8
washer A × 4 | | 0.5
washer B × 4 | | 0.5
magnet Ø4x2 N52 diametric × 4 | | 0.4
M1.6x3 ISO 10642 Ti × 8 | | 0.2
angle sensor IC × 4 | | 0.1

### Verification

Every member pair and the arm-end parts checked for interpenetration in every followed frame (real joint stacks and caps included); frames that could not clear are held, not hidden. Skin clearance ≥ 2 mm in every followed frame from the dense per-frame skin maps.
