aboufama/exo-shoulder/pipeline/conformal/sections/joint_sections.png

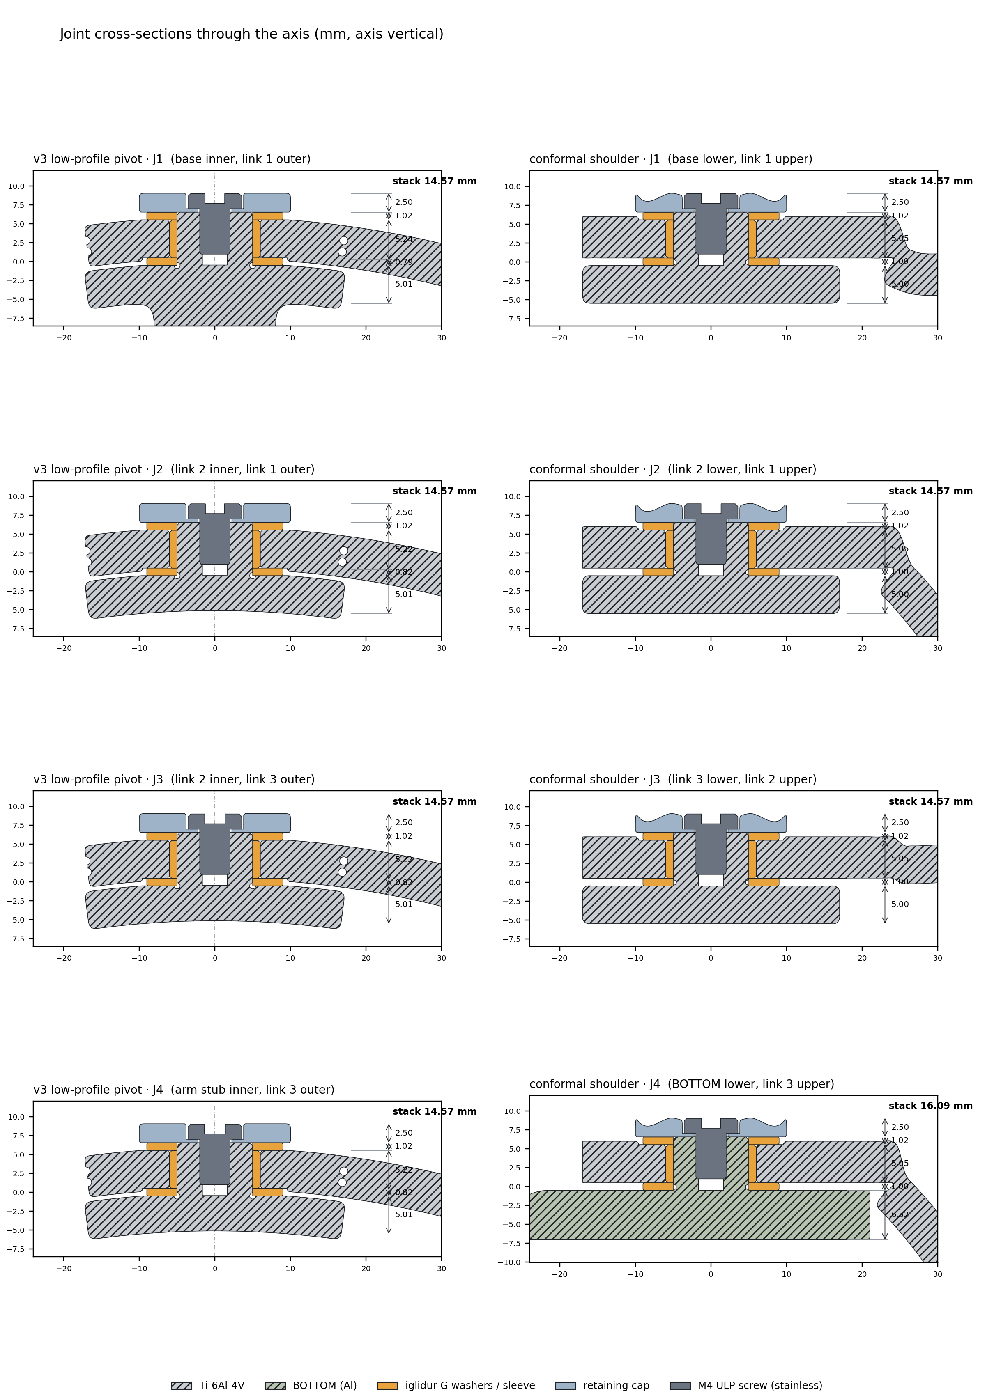
pipeline/conformal/sections/joint_sections.png
