aboufama/exo-shoulder/pipeline/conformal/sections/joint_sections_v0.png

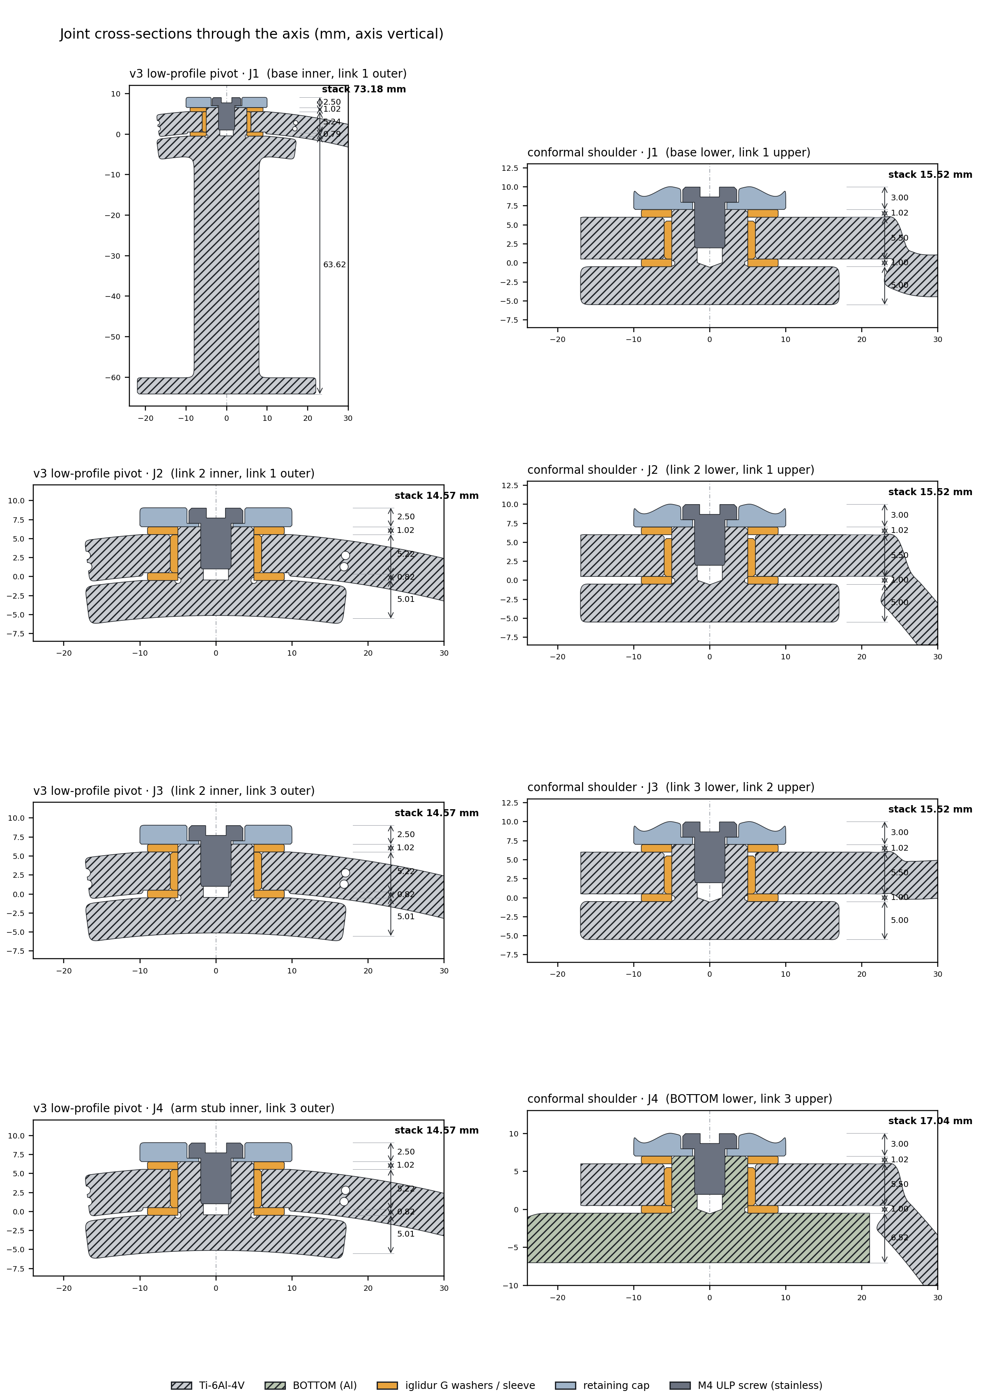
pipeline/conformal/sections/joint_sections_v0.png
