aboufama/exo-shoulder/data/user_cad/RIGHT ARM SUBASSY.step

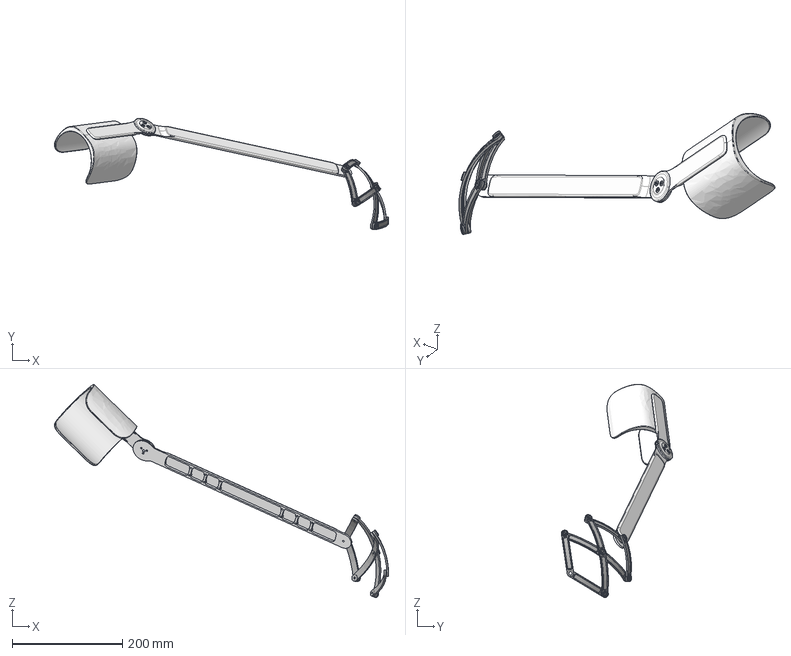
[picture p3: CAD file, 2026-10-14]
data/user_cad/RIGHT ARM SUBASSY.step
607.0 x 202.6 x 387.6 mm
0.245" ID, 0.375" OD PTFE THRUST WASHER x 6
M4 ULTRA LOW PROFILE SOCKET HEAD SCREW, 8mm L, HS STEEL x 6
RETAINING CLAMP x 6
SHOULDER LINK OUTER x 2
SHOULDER LINK OUTER LONG
SHOULDER LINK INNER x 2
DRY RUNNING FLANGED SLEEVE BEARING, 6mm ID, 4mm L, PLASTIC BLEND x 8
SHOULDER LINK INNER LONG
M4 ULTRA LOW PROFILE SOCKET HEAD SCREW, 6mm L, HS STEEL x 3
BOTTOM
FOREARM CUFF
Hex socket head countersunk screw grade C M4x0.7 x 8 x 6
TOP
IGUS THRUST WASHER, 30mm ID, 39mm OD, 1.5mm T, IGLIDE J x 2
MIDDLE
5mm D, 2.5mm H, N42 MAGNET
CirPattern1[15]
Revolve1[2]
CirPattern1[11]
CirPattern1[5]
Revolve1[1]
CirPattern1[7]
CirPattern1[16]
CirPattern1[12]
CirPattern1[14]
CirPattern1[8]
CirPattern1[10]
CirPattern1[4]
CirPattern1[2]
CirPattern1[9]
Revolve1[3]
CirPattern1[1]
CirPattern1[6]
CirPattern1[3]
CirPattern1[17]
CirPattern1[13]
