aboufama/exo-shoulder/pipeline/full-exo/designs/cad_r13_n3_s1331_0/step/UPPER.step

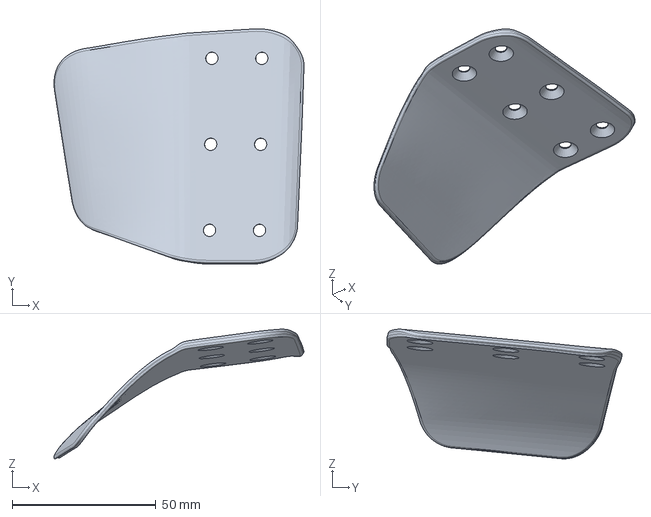
[picture p4: CAD file, 2026-10-15]
pipeline/full-exo/designs/cad_r13_n3_s1331_0/step/UPPER.step
86.8 x 81.7 x 45.1 mm
