aboufama/exo-shoulder/pipeline/full-exo/designs/cad_r13_n4_s1343_1/step/BOTTOM.step

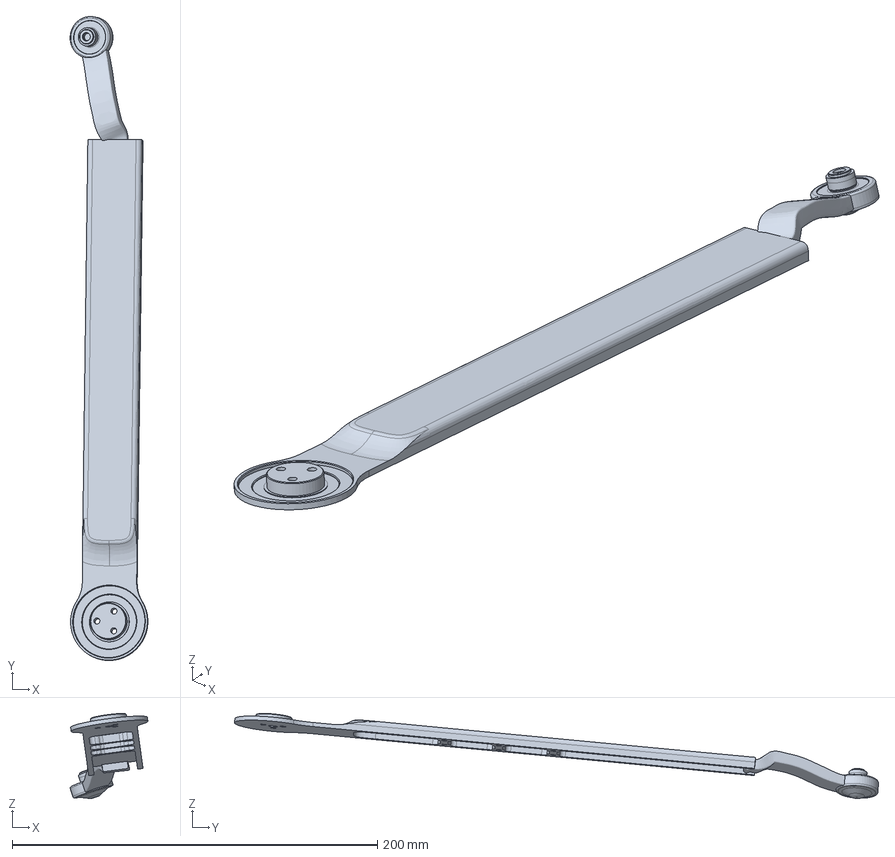
[picture p5: CAD file, 2026-10-15]
pipeline/full-exo/designs/cad_r13_n4_s1343_1/step/BOTTOM.step
42.6 x 352.8 x 46.6 mm
