aboufama/exo-shoulder/pipeline/full-exo/designs/cad_r13_n3_s1331_0/step/D4-01.step

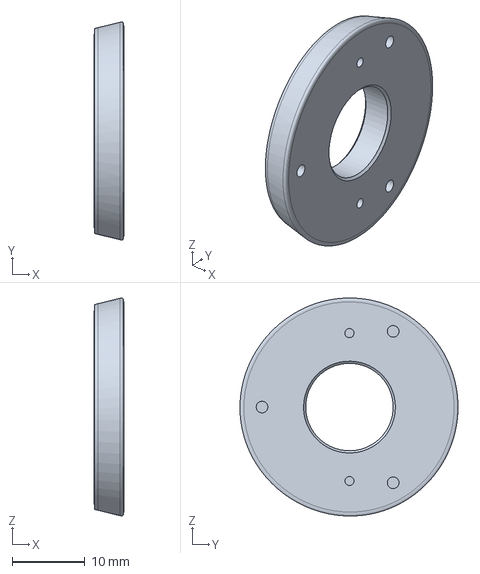
[picture p6: CAD file, 2026-10-15]
pipeline/full-exo/designs/cad_r13_n3_s1331_0/step/D4-01.step
4.05 x 29.9 x 29.9 mm
