aboufama/exo-shoulder/pipeline/full-exo/designs/cad_r13_n4_s1343_1/step/D4-03.step

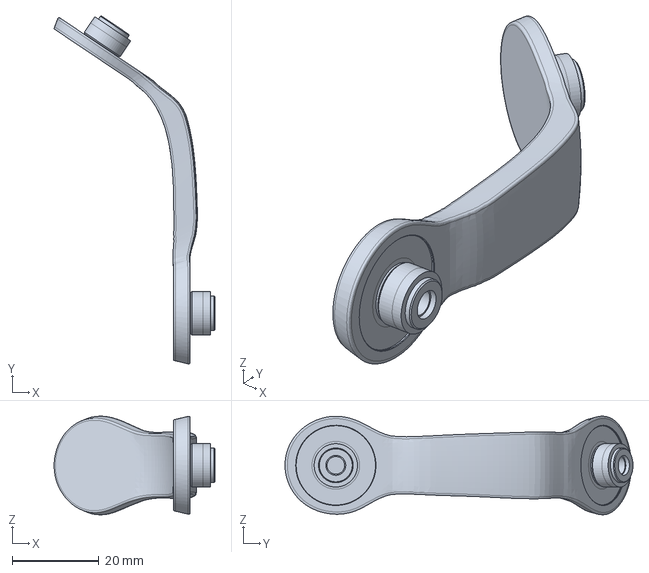
[picture p7: CAD file, 2026-10-15]
pipeline/full-exo/designs/cad_r13_n4_s1343_1/step/D4-03.step
37.1 x 80.2 x 22.8 mm
