aboufama/exo-shoulder/pipeline/full-exo/upper_cuff_cad.step

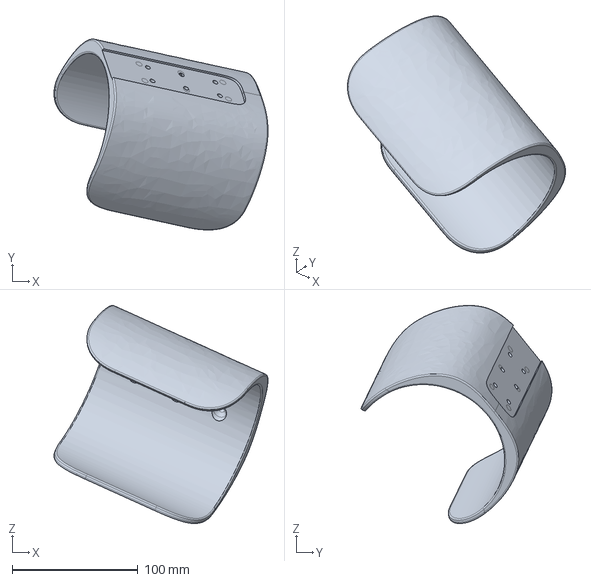
[picture p8: CAD file, 2026-10-14]
pipeline/full-exo/upper_cuff_cad.step
170.0 x 151.6 x 173.2 mm
