aboufama/exo-shoulder/pipeline/full-exo/designs/cad_r13_n3_s1331_0/step/D4-S.step

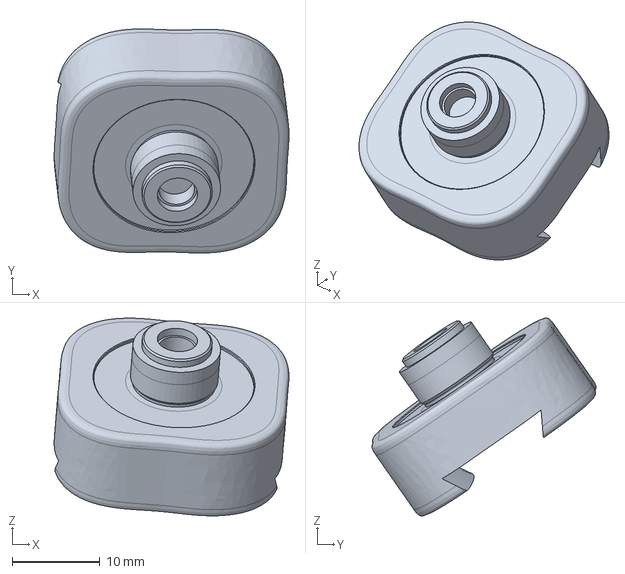
[picture p9: CAD file, 2026-10-15]
pipeline/full-exo/designs/cad_r13_n3_s1331_0/step/D4-S.step
26.8 x 25.5 x 22.5 mm
