aboufama/exo-shoulder/pipeline/full-exo/designs/cad_r13_n4_s1343_1/step/D4-04.step

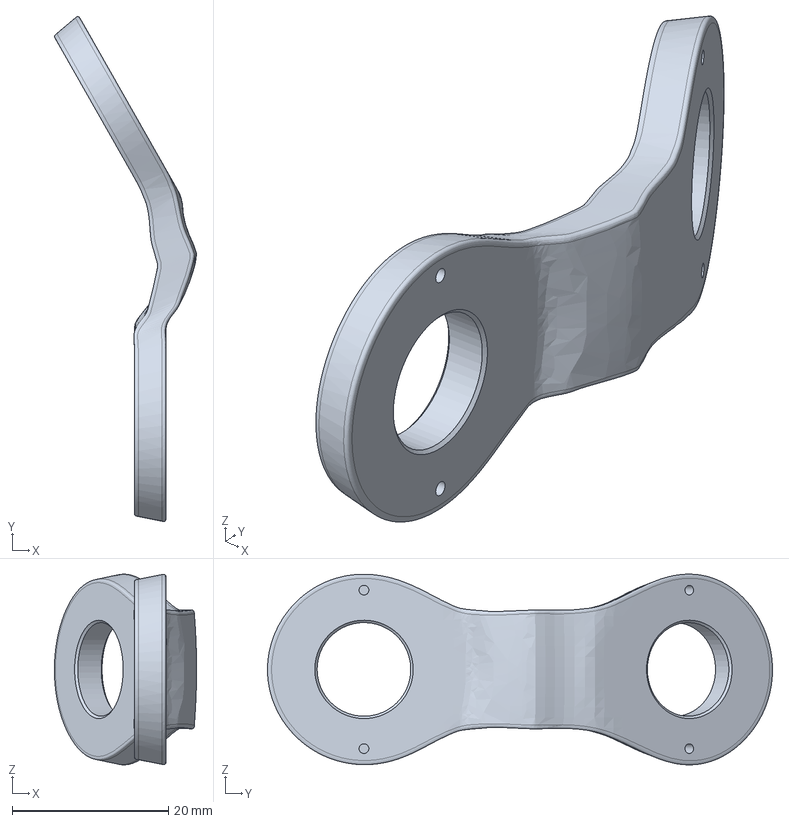
[picture p10: CAD file, 2026-10-15]
pipeline/full-exo/designs/cad_r13_n4_s1343_1/step/D4-04.step
18.2 x 64.7 x 24.4 mm
