aboufama/exo-shoulder/pipeline/full-exo/designs/cad_r13_n3_s1331_0/step/D4-03.step

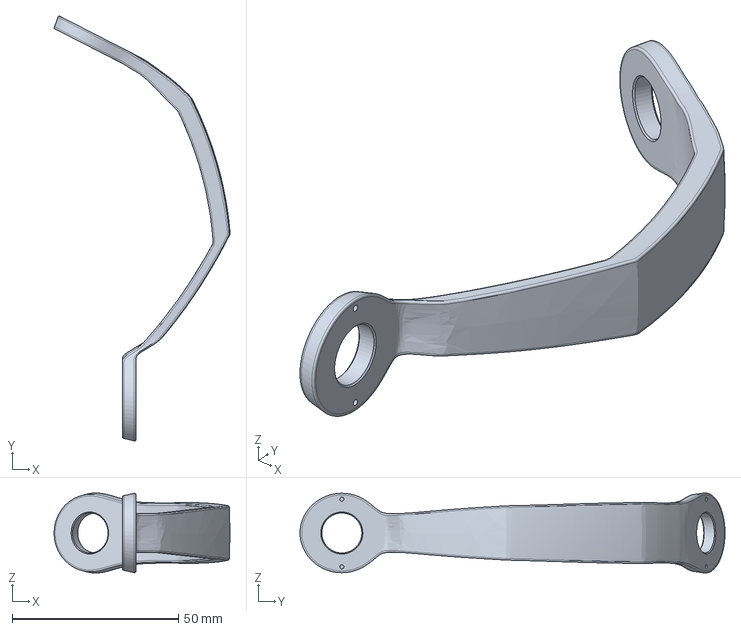
[picture p11: CAD file, 2026-10-15]
pipeline/full-exo/designs/cad_r13_n3_s1331_0/step/D4-03.step
52.8 x 127.7 x 24.0 mm
