aboufama/exo-shoulder/pipeline/full-exo/designs/cad_r13_n4_s1343_1/step/D4-02.step

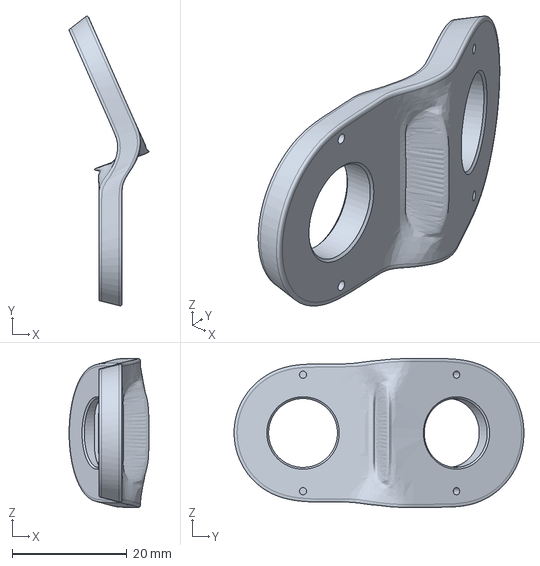
[picture p12: CAD file, 2026-10-15]
pipeline/full-exo/designs/cad_r13_n4_s1343_1/step/D4-02.step
13.9 x 50.5 x 26.0 mm
