aboufama/exo-shoulder/pipeline/full-exo/designs/cad_r13_n3_s1331_0/step/D4-02.step

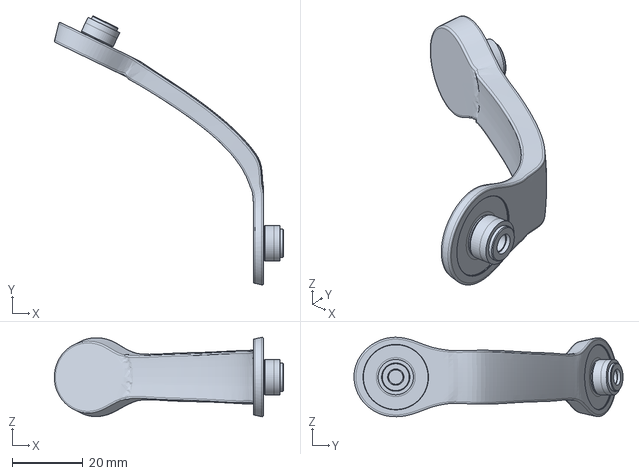
[picture p13: CAD file, 2026-10-15]
pipeline/full-exo/designs/cad_r13_n3_s1331_0/step/D4-02.step
64.8 x 76.0 x 22.5 mm
