aboufama/exo-shoulder/pipeline/full-exo/designs/cad_r13_n4_s1343_1/step/D4-01.step

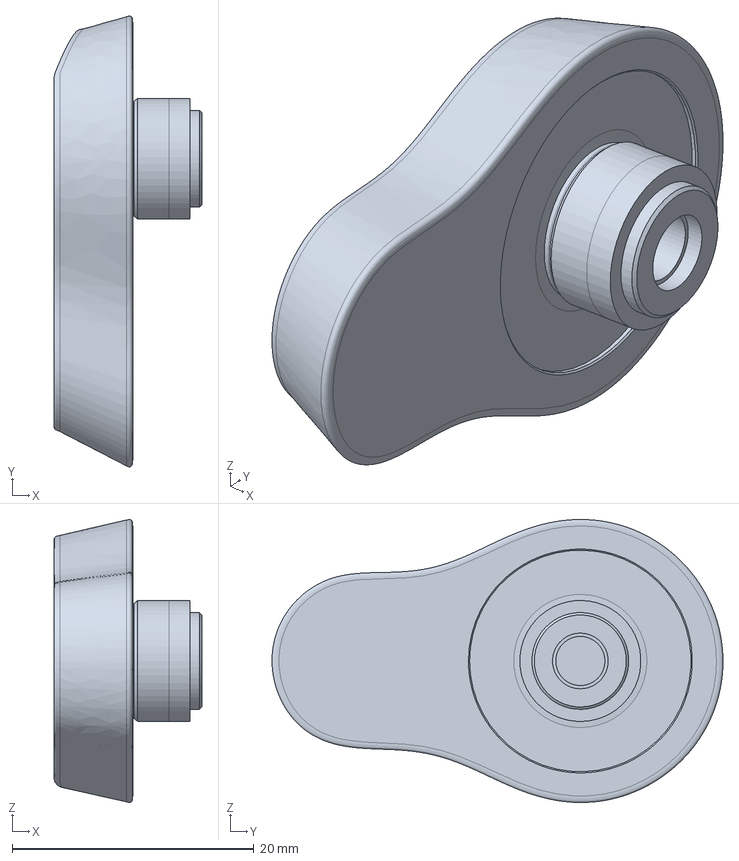
[picture p14: CAD file, 2026-10-15]
pipeline/full-exo/designs/cad_r13_n4_s1343_1/step/D4-01.step
12.2 x 37.3 x 23.4 mm
