aboufama/exo-shoulder/pipeline/full-exo/designs/cad_r13_n3_s1331_0/step/BOTTOM.step

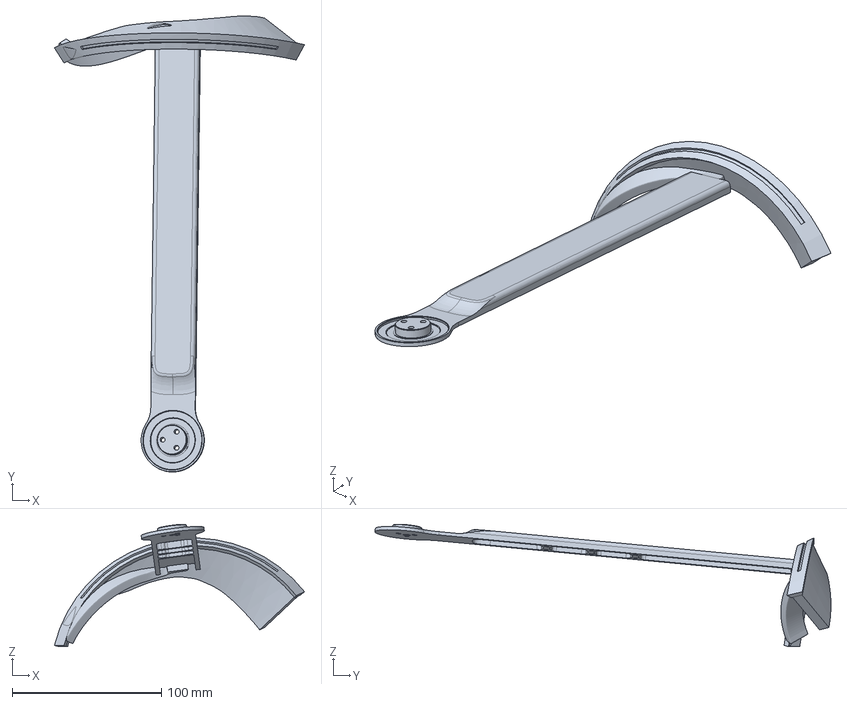
[picture p15: CAD file, 2026-10-15]
pipeline/full-exo/designs/cad_r13_n3_s1331_0/step/BOTTOM.step
167.7 x 305.6 x 82.0 mm
