aboufama/exo-shoulder/pipeline/conformal/fair_cad/out_cuff/screw_4.step

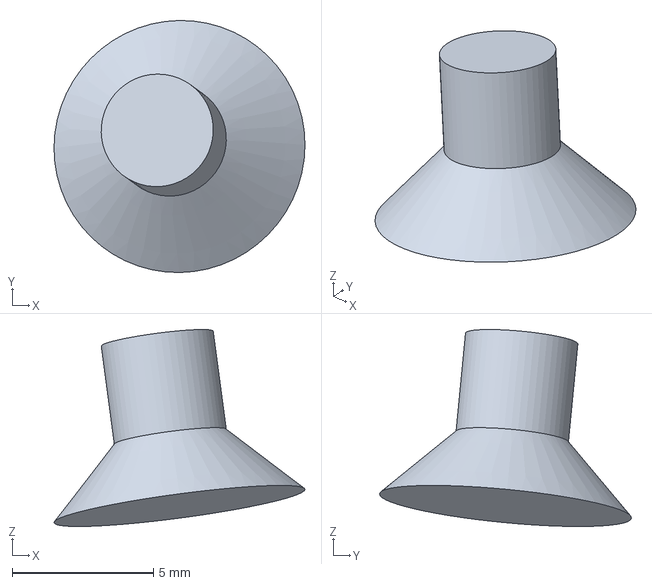
[picture p16: CAD file, 2026-10-14]
pipeline/conformal/fair_cad/out_cuff/screw_4.step
8.88 x 8.92 x 6.97 mm
