aboufama/exo-shoulder/(list of files, cad)

Other CAD files:
pipeline/full-exo/upper_cuff_fair.step
pipeline/full-exo/designs/cad_r13_n4_s1343_1/step/UPPER.step
pipeline/conformal/fair_cad/out_cuff/screw_0.step
pipeline/conformal/fair_cad/out_cuff/screw_2.step
pipeline/conformal/fair_cad/out_cuff/screw_1.step
pipeline/conformal/fair_cad/out_cuff/screw_3.step
pipeline/conformal/fair_cad/out_cuff/screw_5.step
