aboufama/exo-shoulder/(commit log)

2026-10-14 EXO shoulder, restructured around requirements, raw data, methods and outside judges
    - REQUIREMENTS.md: R1-R15 as pass/fail numbers, each with one judge outside the design pipeline
    - docs/PLAN.md: the depth reframing (what a field expert would do, rawest material, instruments, judges) + phases P0-P6
    - docs/FINDINGS.md: everything learned 2026-10-09..14 with numbers (base modelled scapula-fixed, rig artifacts,
    cuff -> saddle, short-link failure, construction rules, evaluator optimism)
    - judge/: exact signed-distance body contact, geometry-only part interference, STEP validity, scorecard
    - data/user_cad: the user's STEP (source of truth); data/raw: capture protocol for scans, OpenCap, OpenSi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
    [BOTTOM.step, D4-01.step, D4-02.step, D4-03.step, D4-04.step, RIGHT ARM SUBASSY.step, UPPER.step, screw_0.step]
2026-10-14 PIPELINE: any CAD build (incl. re-assembly) needs .cache/maps_s1.pt; P0 and the judges do not
2026-10-14 Judges finish on all cores; R10 becomes a judged number; P0 girdle analysis; P3 plan, split, raw-data asks
    - judge/body_contact.py, part_contact.py: --jobs N splits frames over processes (default min(4, cores)),
    merged in frame order: identical output to the serial run (checked at step 150). R2/R6 never completed
    before (~85 min single-threaded on the reference design).
    - judge/base_mount.py (R10): GH-centre misalignment and base-part body contact with the base THORAX-fixed
    (the physical back plate), rig girdle law until OpenSim / OpenCap replace it. requirements.json R10:
    <= 4 mm (proposed, half the 2-10 mm band); scorecard + judge_all.sh run it. Measurement change: R10 was
    OPEN,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
2026-10-14 Synthesis: every link has a real arm (min_arc 35 deg, min_arm_mm 10 mm)
    docs/FINDINGS.md "Short link": r13's link 1 (23.9 deg) put its two hubs side by side
    (1.7 mm between the O23 seats). The search now forbids it.
    - band_impl: job keys min_arc (deg, default 35) and min_arm_mm (mm, default 10);
    0 switches a rule off (to re-score old designs).
    * samplers moved to make_samplers(job, rng); arcs drawn / mutated in
    arc_bounds(job) = [max(arc_range[0], min_arc), arc_range[1]]; init seeds are
    projected into the same bounds.
    * Band.evaluate rejects a design with any link arc < min_arc before any work
    (score -1, err "short link: link k arc .. deg (.. mm between hub seats at R 65)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
2026-10-14 band_impl: CODE_VERSION band-2026-10-15t (min link arc / min arm guard)
    Warm RunPod Flash workers keep old code (docs/FINDINGS.md "Infrastructure"): a client
    now sees from the version whether the worker enforces min_arc / min_arm_mm. Not deployed;
    deploy under a new endpoint name before the next search.
    Claude-Session: https://claude.ai/code/session_01HShoE3xJTcjMWRx4v2yePx
2026-10-14 CAD guard: no CAD from a design whose link has no real arm
    - make_cad_design.py refuses (exit 2) a design with a link arc < 35 deg or < 10 mm clear
    between a link's hub seats (band_impl.design_link_report; env MIN_ARC / MIN_ARM_MM
    change the thresholds) unless --allow-short-link or ALLOW_SHORT_LINK=1 - to be used only
    with the user's OK. Checked before anything is written. Missing kinematics / arm_mm in an
    old clips.json are reported, not silently passed.
    - band_to_design.py warns loudly on stderr (still fine as a scoring proxy for
    verify_top / honest_climb), exits on a result the evaluator rejected, and writes hub_r and
    arm_mm (clear mm per link at the fitted hub heights) into c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
2026-10-14 test_band_guard.py: CPU checks of the link-arm guard and the 3R chain (no maps)
    python3 pipeline/conformal/gpu_client/test_band_guard.py (~30 s, 2 threads, one process;
    pytest-compatible). Uses the real poses with a synthetic skin (sphere round GH) injected into
    band_impl's cache, so it needs neither .cache/maps_s1.pt nor a GPU.
    - pure rules on r13: link 1 23.9 / link 3 29.6 deg rejected; fitted hub planes 57.1 / 62.0 mm
    from GH -> 2.1 mm between link 1's seats (FINDINGS measured 1.7 on the CAD).
    - samplers: 3000 rand_d + 3000 chained mutations (from a parent at 1 deg) per case, N = 3,
    3 + cuff, 4: no arc outside [max(arc_range[0], min_arc), arc_range[1]].
    - Band.evaluate: r13 -> score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
2026-10-14 band_impl: document the pure 3R chain (N = 3, no cuff) - supported as is
    Checked rather than assumed (test_band_guard.py): with N = 3 and no cuff, chain() has
    m = 0 spare angles, one configuration per pose (C = 1, Q (1, 0)), p2 from the two-circle
    closure of b and HG W (closure error 1e-7 over the poses), neighbours() / dp_path() handle the
    empty grid, evaluate() runs end to end, and band_to_design's m = 0 paths exist. run() searches
    it when cuff_range is unset. No code change needed; tri_ok's sing_deg margin is the only
    guard against the 3R singularity, and no joint-speed limit applies (no spare joint).
    Claude-Session: https://claude.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
2026-10-14 FINDINGS: the short-link guard and what 35 deg means in mm
    Records the new job keys (min_arc 35 deg, min_arm_mm 10 mm), the CAD refusal, and the
    numbers: 35 deg = 16.1 / 13.1 / 10.1 / 7.1 / 4.1 mm between O23 seats (r 11.5) at hub radius
    65 / 60 / 55 / 50 / 45 mm (5.1 mm at 65 with r 17 seats); r13's link 3 (29.6 deg) has 16.9 mm
    at its fitted 74 / 80 mm hubs, so the two rules disagree there.
    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
2026-10-14 CAD in two levels: L1 keep-out CAD for every iteration, the user's standard (L2) only for a validated, chosen design
    User, 2026-10-14: "you dont need to make high quality CAD with smoothing for each iteration and testing ... Just a
    basic CAD that has the expected keep outs of the joint, expected link height, etc." CLAUDE.md required the zebra check
    for every part shown, which forced fair G2 CAD into every iteration; now L1 (keep-outs, real heights, valid solids,
    motion judges) iterates and L2 (CAD_STANDARD.md, zebra) is phase P4 only. P3 plan uses an L1 builder.
    tools/scorecard_diff.py: scorecard before vs after (any git revision), flags measurement changes.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
2026-10-14 Judges and the honest scorer accept an optional per-group translation T per frame
    Chains with offset axes (P0's 3-DOF candidates) move links by rotation AND translation; clips.json frames may now carry
    "T": {group: [x, y, z] mm} next to "G". Missing T = 0, so every existing design is measured exactly as before.
    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
2026-10-14 P0 base-mount physics (R10): thorax plate rules out fixed-centre chains; 3-DOF offset-axis chains reach 5.8 / 6.8 mm
    On the rig's girdle law, every frame of the 8 clips (docs/P0_BASE_MOUNT.md, pipeline/girdle/p0_results.json):
    - GH centre rises up to 25.3 mm vs the thorax; the scapula (the pipeline's base frame) turns up to 57.8 deg.
    - The reference base on a thorax plate moves up to 57.6 mm from where the pipeline put it and enters the body in
    197 of 446 frames, up to 44.0 mm (Raise overhead, 30/150/-60).
    - Reference chain on a thorax base: GH misalignment 25.3 mm worst, > 4 mm in 48 % of frames. Any chain whose axes meet
    at one thorax-fixed point misaligns >= 12.7 mm: wider than the wh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
2026-10-14 FINDINGS: the base mount, measured (P0): fixed-centre bound, offset-axis 3-DOF numbers, ring travel and roundness
    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
2026-10-14 Research notes (biomechanics, precision hardware) + where a thorax-fixed joint can sit + the literature girdle law
    - docs/research/gh_translation_literature.md (biomechanics evidence work): the rig's girdle law is 2-3x too small,
    starts too late and misses posterior / medial motion: published bone-pin data through a rigid clavicle chain give
    GH +35 mm superior at 90 deg scaption (rig 12.7), plus up to 24 mm posterior and 22-28 mm medial; vector error of
    the rig 16-51 mm. +-7-12 mm (1 SD) is not a function of arm orientation. Acromion plates track the scapula to 5-7 deg
    below 100-120 deg elevation, up to 25 deg above.
    - docs/research/ring_and_shell_hardware.md (precision-mechanism com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
2026-10-14 P0 against published girdle motion: no rigid thorax-plate chain within the cap holds the band; three ways forward
    Literature law (bone-pin clavicle / scapula chain, docs/research): the reference chain on a thorax plate misaligns 64.9 mm
    (rig law: 25.3); the rig-fitted 3-DOF designs 47 mm; refitted to the literature law, 3R 10.7 mm on the fitting clips /
    25.9 held out, 2R + ring 19.2 / 21.7; fitted to both laws ~23 mm - plus +-7-12 mm of girdle motion that is not a function
    of arm angle. Ring trade-off (ring_pareto.json): ring travel 196 -> 71 deg costs 0.3 mm on the rig law. Decision options
    A (3 DOF on a girdle-riding base), B (thorax plate + passive girdle, 5 DOF), C (thorax plate + 3 rigi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
2026-10-14 pipeline/girdle/hug.py: L1 keep-out build of a 3-DOF chain on a thorax plate, judged by the existing judges (P3 instrument v1)
    Hubs = cylinders of the real v4 stack, links = 5.5 mm slabs on the swept skin envelope (exact posed skin, fitting clips
    only), the humeral ring = an arm-fixed shaped rail + a carriage on link 2; writes design.json (offset3 base for R10),
    clips.json with per-frame G and T, exo.glb, parts_full.json. First use: P0's rig-optimal 3R is physically infeasible -
    its J1 axis points where the arm goes overhead, so the thorax-fixed J1 hub lands 160 mm out and 690 / 1337 frames are
    blocked: kinematic fits are seeds, not designs.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
2026-10-14 P3 plan: the base model follows the user's P0 decision (A girdle-riding / B passive girdle / C thorax plate)
    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
2026-10-14 Baseline scorecard, full judge run (step 1): R2 and R6 complete for the first time, R10 measured
    tools/judge_all.sh cad_r13_n4_s1343_1 (full: R2 every 2nd frame = 671 frames, R6 every 4th = 339 frames x 3738 pairs,
    R10 every 3rd), 97 min on 4 shared cores. No design change. Measurement changes only:
    - R2 (new): 24.43 mm FAIL - worst J4 washer A at deep elbow flexion (Drink, frame 108, 21 frames); the user's FOREARM
    CUFF (24.2 mm) and BOTTOM + neck + JN hub (13.6 mm) sit inside the rig's arm in EVERY frame: a rig-vs-user-arm size
    mismatch (P2 scans) as much as a design error.
    - R6 (new): 18.52 mm FAIL - FOREARM CUFF in BOTTOM at deep flexion; several constant 4.7-4.8 mm overlaps in every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
2026-10-14 Red team: jamming poses, pressure points, attacks on P0 (pipeline/redteam/REPORT.md)
    Top findings: (1) the 3-DOF offset-axis claim holds only on the rig law over the 8 clips - over the plausible workspace
    13.7 (ring) / 18.1 (3R) mm, literature law 47-50 (refit 25-35), +15 mm shrug 19-22; any orientation-only chain is >= 12.5
    mm off for a -10..+15 mm girdle range. (2) The thorax-fixed base goes into the acromion from 52 deg elevation (44 mm at
    150). (3) The reference 4R cannot close in 19 % of the plausible workspace (47-49 % cross-body). (4) P0's 3R has
    a1 ~ a2: gimbal lock at an arm-forward pose near walking. (5) Neither ring candidate both closes over the workspace and
    fits its track (leas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
2026-10-14 L1 counter-example judged: P0's rig-optimal 3R fails every motion judge once built (R1 0.1 %, R2 25 mm, R6 51 mm, R10 5.8)
    judge/part_validity.py: L1 keep-out designs (no STEP) are judged as closed meshes (one closed volume per custom part),
    labelled level L1. pipeline/full-exo/designs/l1_3r_offset: built by pipeline/girdle/hug.py, judged by
    tools/judge_all.sh fast - outside judges confirm that a kinematics-only fit is a seed, not a design.
    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
2026-10-14 Requirements: the user's DOF counting rule (kinematic, every joint counts; one torque-free passive self-aligning joint excepted), thin Ti links, OpenSim download + licence accepted
    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
2026-10-14 P0 section 8: the user's torque-free passive-joint exception holds ~4 mm under both girdle laws
    One self-aligning passive slider (Stienen et al. 2009 principle: decouple rotations from translations; a prismatic
    joint passes every moment, so the assist torque reaches the plate as a pure couple) between the thorax plate and the
    3-DOF shoulder: 2R shoulder + humeral-rotation ring + offset axes + slider, fitted to rig AND literature laws: 3.99 mm
    worst on the fitting clips under both (held-out 4.9 / 7.8 mm), slider travel ~56 mm along ~(-0.4, 0.76, -0.5) - up,
    medial, slightly posterior: the line clavicle elevation carries the shoulder along. 3R + slider: 4.7 mm. Spherical +
    slider: 7.9-9.7 mm.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
2026-10-14 OpenSim Seth 2016 cross-check: a third girdle law from the field's instrument (pipeline/girdle/opensim_seth)
    OpenSim 4.6 (isolated venv, .cache/opensim-venv) + the generic Seth et al. 2016 scapulothoracic model (CC BY-NC-SA 3.0,
    accepted by the user; the archive's restricted bone-pin data was neither used nor kept), driven by published mean
    Ludewig 2009 clavicle / scapula angles (figure-read). GH vs the thorax at 90 deg: abduction -10.2 / +28.9 / -4.9 mm
    (ant / sup / lat), scaption 0.5 / 25.5 / -2.8, flexion 4.1 / 20.3 / -3.6: superior 1.6-2.3x the rig law, 0.71-0.84x the
    literature chain; much less posterior / medial than the chain (shorter clavicle 125 vs 154 mm, AC-GH 42 vs 46 mm, girdle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
2026-10-14 R10 judge: worst over three girdle laws (rig, literature chain, OpenSim Seth model) + slider-aware
    Measurement change, not a design change: the reference's R10 goes 25.34 -> 64.89 mm (rig 25.3, literature 64.9,
    OpenSim Seth scaled to the rig 62.9). girdle.lift_laws() gives all three; judge/base_mount.py reports per-law maxima and
    the worst; designs may declare one torque-free passive slider ("slider": e) - the user's DOF exception.
    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
2026-10-14 P0 8b: self-aligning designs against all three girdle laws: ~6.5 mm floor = the disagreement between published girdle models; the user's own girdle data is now the critical path
    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
2026-10-14 P0 8c: self-aligning 2R+ring over the whole plausible workspace: 8.7-9.0 mm worst, held-out clips 5.0/3.5; the pointing singularity cannot hide (8.6 deg) and the ring must turn a full circle over ful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
2026-10-14 P0 8d: no 3-DOF rotation chain is singularity-free over the full plausible ROM (best 8.7 deg clearance): 3 DOF parks the singularity at a rare extreme, full ROM needs the 4th joint
    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
2026-10-15 r14 GPU search (RunPod exo-band12, ~$1.3): first 3-DOF design through L1 CAD + judges beats the reference on follow, overhead, score, mass
    Search on the girdle-riding base (option A), fitting clips only: pure 3R best 41.4 / 40.6 / 32.2 %, 4R control 47.7 %
    (evaluator scores). On all 8 clips (held-out included): 3R s1351 rank 1 35.7 % (follow 93.5 %), 4R 40.2 %; the
    fitting-clip leader (3R s1351 rank 0) drops to 21.9 % - overfitted, caught by the held-out split. Hand designs
    (posterior arch, lateral cap) 4-22 %; anterior variants rejected (no back anchor): the search beats them.
    L1 keep-out build of 3R s1351 rank 1 (pipeline/girdle/hug.py --base girdle), judged: R1 overall 35.4 % (ref 29.6),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
2026-10-15 Arm end: turned, skin-fitted JN hub skin side; robust neck, sheet sewing and 3R arm-end builders
    JN hub (r13_n4_s1343_1, Task 1): the turned hub's skin side is again fitted to the dense
    skin envelope, as a revolved sketch (centre flat + cone, optionally returning to the old face F
    = "dimple"; short G2 corner blends). Per ring: max over the ring and all followed frames of
    skin + 2 mm + 0.5. Result: centre 3.1 mm under F to r 2.5, 25 deg cone back to F by r ~10.
    Radial skin gap under the hub: min 3.15 -> 2.71 mm, worst-frame median 7.14 -> 4.78 mm.
    Neck: no longer morphs into BOTTOM's 30 mm bar section (that folded the loft). It stays
    14 x 5.5 and runs 6 mm into BOTTOM. It starts 5.9 thick in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
    [BOTTOM.step, D4-01.step, D4-02.step, D4-03.step, D4-04.step, UPPER.step]
2026-10-15 3R + sliding cuff arm end (r13_n3_s1331_0) built with every part valid; findings on travel limits and the contact judges
    New design dir cad_r13_n3_s1331_0. Built with fair_pipeline.sh on the official skin maps;
    uses the builders from the previous commit.
    Reproduced root causes (old code, toggles SEW_V1=1 BASE_CAP=0 RAIL_V1=1 NECK_END=bar):
    - member sheet sewn at 5 um, then the FIRST shell taken -> link 1 an invalid 4-face open
    shell on the official maps. FINDINGS saw the same on link 2 as "zero volume".
    - link 2's ribbon floor started 29 mm above J2's plane: an 85 deg wall, J2 raised 12 mm,
    link 2 8 mm inside the envelope
    - rail + neck as one loft: self-intersecting, the BOTTOM merge re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
    [BOTTOM.step, D4-01.step, D4-02.step, D4-03.step, D4-S.step, UPPER.step]
2026-10-15 band_to_design: ARM_SRC / ARM_SKIP; r14 3-DOF design built faithfully from the evaluator's fitted shape and judged
    designs/band_r14_3r_s1351_1 (pure 3R, girdle-riding base, RunPod r14 search): judge_all fast - OVERALL 52.8 %
    (reference 29.6 %), follows 91.6 %, in-band 57.7 %, overhead 57.6 % (ref 18.8 %), R5 3 DOF. R2 24.95 / R6 8.88 mm are
    NOT trustworthy yet: judge/sdist.py takes the inside/outside sign from one nearest triangle (the CAD agent re-tested
    the reference's worst R6 pairs by ray parity: 0 points truly inside). Fix next, then re-judge.
    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
2026-10-15 RunPod cost guard (audit / enforce / watch) + cost log; r15 3R search configs and results
    tools/runpod_guard.py: stdlib-only watchdog (key from RUNPOD_API_KEY or ~/.runpod_key, Bearer header,
    never printed; never touches crl-* pods). docs/RUNPOD_COSTS.md: per-batch spend (session $2.94 of a
    $5 cap), $/1000 evals per device, recommendations. r15: 4 pure-3R seeds, best fit score 0.427
    (r14: 0.414); every 3R still fails Reach back pocket (score ~0.12).
    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
2026-10-15 Contact judges (R2, R6, R10 base part): exact closest point + integer winding number
    judge/sdist.py: Mesh class. Closest point exact (surface samples covering every triangle within h; one ball
    query of radius nearest-sample + h is a complete candidate set). Inside = integer winding number from a grid of
    signed scanline crossings plus the signed crossings of the segment node -> point (exact for closed meshes, and
    right where the posed body self-intersects). The old rule (sign of the nearest of 10 centroids' face normal)
    missed the true closest triangle on long glb facets and the coarse body mesh (median edge 8 mm, max 87 mm):
    e.g. 'link 2 IN J2 cap' 4.78 mm where ray parity (3 directions) and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
2026-10-15 14 mm band scores (user's allowance) for the r14 3R and 4R L1 builds
    score_design.py BAND_HI=14: 3R 64.5 % (10 mm: 52.8 %), 4R 75.1 % (10 mm: 49.7 %). Same geometry and clips;
    only the band's upper edge moved (measurement, not design). The 3R gains less: Reach back pocket stays at
    19.8 % (it follows that clip 17-20 % of the time).
    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
2026-10-15 14 mm band score for the reference 4R CAD (cad_r13_n4_s1343_1)
    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
2026-10-15 User decisions 2026-10-15: scapula base on the user's handler, exactly 3 DOF shoulder chain, pass at 14 mm aim 10
    REQUIREMENTS.md / judge/requirements.json: R1 and R4 judged on the 2-14 mm band (score_14mm.json), R1-aim keeps
    2-10 mm; R5 counts the shoulder chain only (the scapula handler is the user's separate part), R5-aim = 3 DOF;
    R10 = base slip over the scapula (model to build). judge_all.sh also scores at 14 mm. CLAUDE.md and
    docs/P0_BASE_MOUNT.md record the decisions in the user's words.
    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
2026-10-15 Why 3R loses clips, what limits proximity, and a search that must clear the whole workspace
    - analysis/reach3r.py: every r14/r15 3R design reaches every frame of every clip kinematically (Reach back pocket
    included); the clip is lost to the skin / shape trade-off, not to the joint geometry.
    - inband_ceiling.py: with a perfect underside the r14 3R could have 74 % in band (10 mm) / 82.5 % (14 mm); the built
    shape gets 44.9 / 56.9 %. Most of the gap is the last link (member 2: 22 % vs 87 % at 14 mm), held up by the
    BOTTOM hub it sits on. analysis/hub_sensitivity.py: the ramp a link may leave a hub at is the lever (35 -> 65 deg:
    14 mm in band 56.9 -> 68.2 %, member 2 22 -> 53 %); hub rad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
2026-10-15 Red team: sim-to-real register (20 gaps, ranked) - how the exo could pass every judge and still fail on a person
    docs/research/sim_to_real_gaps.md, with four CPU checks (pipeline/redteam/rt_wedge.py, rt_misalign.py,
    rt_jointbox.py, rt_simreal_misc.py). Top 5: no actuator keep-out; the assist reaction has no acceptable path at the
    scapula saddle; exactly 3 DOF + a rigid cuff is over-constrained (GH-centre error goes into the skin); the soft arm
    interface (cuff moves 11-27 mm under assist); nothing holds the 2 mm floor (deflection, external pushes). The
    user's friction worry: with load-dependent plain-bearing friction the 3R designs self-lock at mu_eff 0.22-0.30 (the
    4R at 0.12), against 0.06-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
2026-10-15 User hardware decisions: remote cable actuation, gravity-level assist, passive self-aligning cuff slides, rolling bearings
    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
2026-10-15 Reference re-judged with the fixed contact judges (measurement change) + scapula base; envelope poses droppable at a price
    cad_r13_n4_s1343_1: R6 37.64 -> 0.80 mm, R2 24.43 -> 24.62 mm (user's forearm cuff vs the rig), R1 now on the
    14 mm pass band 80.2 % (aim 2-10 mm 49.6 %), R4 (14 mm) 36.1 %; base = girdle mount (the user's scapula handler)
    -> R10 NOT RUN until the skin-slip model exists. Scorecard and diff tool print units (0.8 mm was shown as 80 %).
    band_impl w: workspace poses may be given up, at a price (score x share of the workspace it moves through) - an
    arm-fixed hub can truly press into the chest in extreme cross-body poses (smoke14: zj4 268 mm, every score 0).
    exo-band15 deploye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
2026-10-15 Workspace test on band15: current designs move through only 34-48 % of the everyday workspace; r16 launched on it
    smoke15 (fit clips + 2080 workspace poses, held-out clips evaluated): r14 3R follows held-out Wave 100 % (15.8 %
    with the fit-only shape) but only 34 % of the workspace; r15 3R 36 %; r14 4R 48 % (and Wave 41 %). r16: 4 x 3R
    search jobs on the fit clips + a 20-deg workspace (920 poses), G = 14 mm, links 4 mm, ramp 35 / 60 deg, balance
    0.4 / 0.7, score x workspace share. pack_envelope.py: no pose filter (see its docstring).
    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
2026-10-15 v5 joint concept for the user's choices (rolling bearings, cable drive): proximity cost measured
    2x 6700 bearings inside a taller upper hub cost 0 pts; a separate O26 drum costs 5.2 pts (hub collisions), so the
    cable groove goes into the O23 hub rim (~950 N at the gravity-level design load: O1.2 Dyneema). Ramp 60 deg +5.6.
    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
2026-10-15 band_r14_3r_s1351_1 re-judged with the fixed contact judges and the 14 mm pass band (measurement changes)
    R6 8.88 -> 1.09 mm (1 pair > 0.15 mm), R2 24.95 -> 24.87 mm (the user's forearm cuff vs the rig), R1 57.7 % (10 mm)
    -> 70.4 % on the 14 mm pass band, R4 57.6 -> 68.9 %. 2 of 17 pass (R5, R5-aim: exactly 3 DOF).
    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
2026-10-15 WIP (unvalidated, not in judge_all or the scorecard): MuJoCo dynamics judge snapshot from the dynamics agent
    Pushed so the work survives the ephemeral container; the agent is still adding load-dependent joint friction and
    the validation against transmission.py / rt_wedge.py. Reviewed and committed properly when it reports.
    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
2026-10-15 Contact judges on open meshes + 3R re-judge + outside cross-check (measurement change)
    judge/sdist.py: Mesh welds vertices first (glb = one tessellation per B-rep face; the pseudo-normal sign needs shared
    edges) and knows whether it is closed. An open tessellation (the 3R BOTTOM + rail keeps 11 boundary + 4 non-manifold
    edges after welding) gets winding sweeps along x, y and z: the majority per node, the generalized winding number where
    they disagree or where the node -> point segment passes a face on a hole. Closed meshes (every other part, the body)
    are unchanged. judge/part_contact.py no longer skips open parts as containers (38 pairs on the 3R, incl. the cuff's
    liners on the rail). judge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
2026-10-15 Re-judge the last old-rule designs; signed_distance takes its sign from the winding number
    Measurement changes (no design changed), fast judges, outside check (judge/xcheck_contact.py) agrees with every top
    entry to 0.00 mm:
    - band_r14_4r_s1354_0: R2 24.15 -> 24.87 mm (the user's forearm cuff), R6 14.80 -> 0.00 mm (passes; its 3 open parts
    are now tested as containers)
    - l1_3r_offset: R2 24.98 -> 24.94 mm (real), R6 50.84 -> 2.40 mm
    - l1_r14_3r_s1351_1: R2 24.89 -> 0.00 mm (passes: the old entries have 0 vertices inside by brute force, and no skin
    vertex is inside its coarse keep-out meshes either), R6 11.09 -> 2.39 mm
    judge/sdist.py: Mesh.signed (signed_distance, used by the red-team a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
2026-10-15 cad_r13_n3_s1331_0: full-resolution contact judges (R2 step 2, R6 step 4) + outside check
    R2 21.94 mm and R6 0.55 mm as in the fast run; BOTTOM 5.98 mm in the user's bar, neck + rail 1.16 mm ('Wave' 62); the
    flank liner in the BOTTOM + rail in 83 of 339 frames. judge/xcheck_contact.py agrees with all 11 top entries to 0.00 mm.
    Claude-Session: https://claude.ai/code/session_01DdGQCzVPW4MX6pgpMh7stW
2026-10-15 Contact judges: re-orient faces (band proxies come mixed / inside out); weld only open meshes
    judge/sdist.py: Mesh orients faces consistently (sdist.orient: across every two-face edge, then each closed piece
    outward). Every band_* build's proxies (D4 members, BOTTOM JN hub block, carriage) are watertight but have mixed
    orientation, some wholly inside out: a winding number never sees inside them. Mesh welds only a mesh with boundary
    edges (glb tessellations); the body is closed as given and welding merged 16 coincident vertex pairs into non-manifold
    edges (R2 took the open-mesh path: still exact, slower; re-ran identical). The mesh cache key includes the faces.
    judge/xcheck_contact.py: R6's i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
